utkuoguzman/Microduck/docs/media/microduck_gifs/real-robot.gif

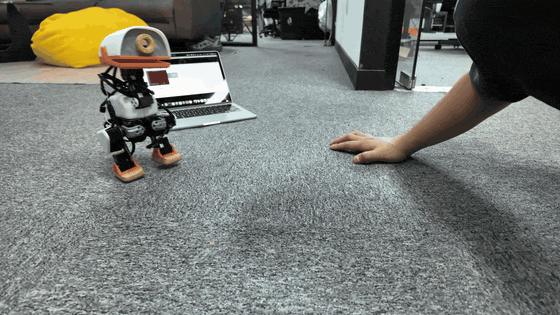
docs/media/microduck_gifs/real-robot.gif
