utkuoguzman/Microduck/docs/media/pcba-v1.1/ArduinoUnoQ-board-photo.jpg

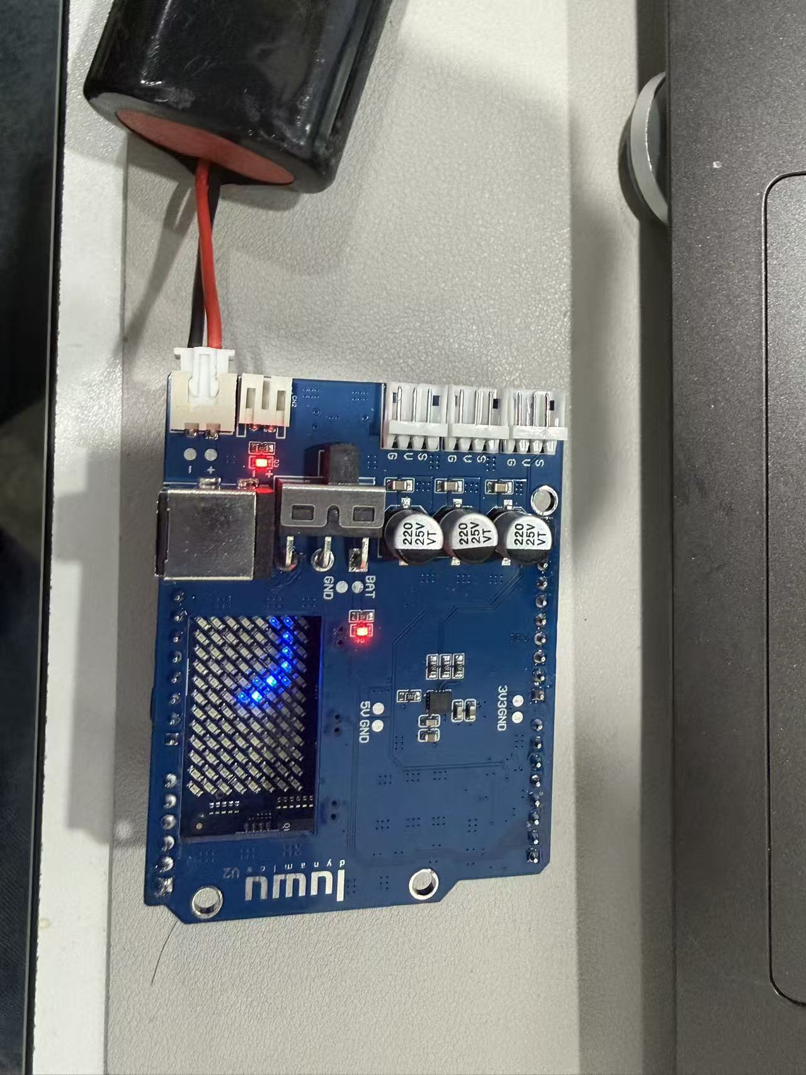
docs/media/pcba-v1.1/ArduinoUnoQ-board-photo.jpg
