utkuoguzman/Microduck/docs/media/xgo-duck-hero.jpg

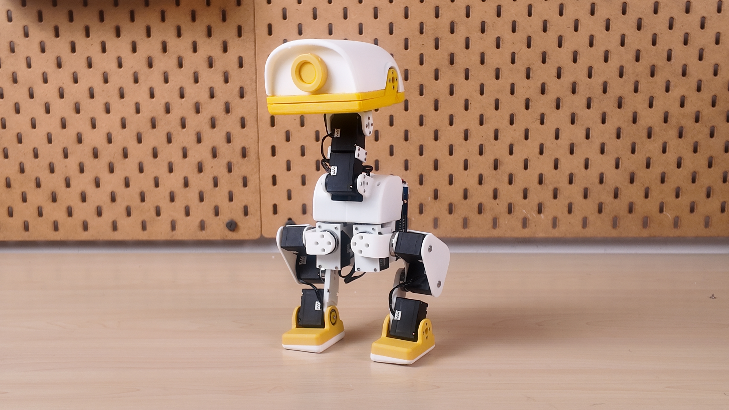
docs/media/xgo-duck-hero.jpg
