utkuoguzman/Microduck/docs/media/xgo-duck-open-beak.jpg

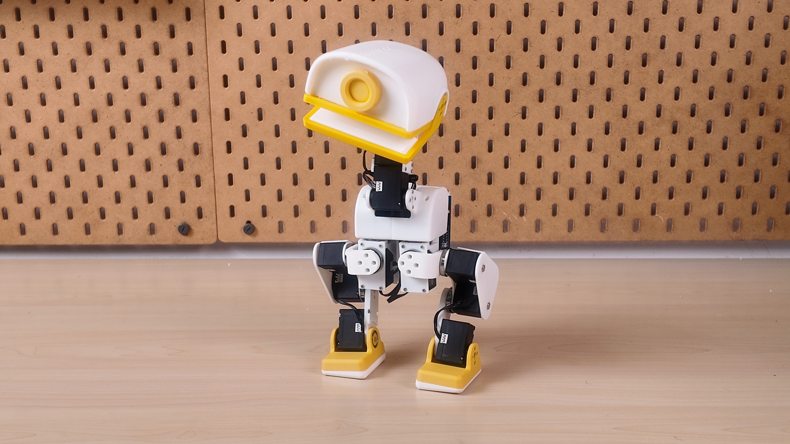
docs/media/xgo-duck-open-beak.jpg
