utkuoguzman/Microduck/docs/media/xgo-duck-rear.jpg

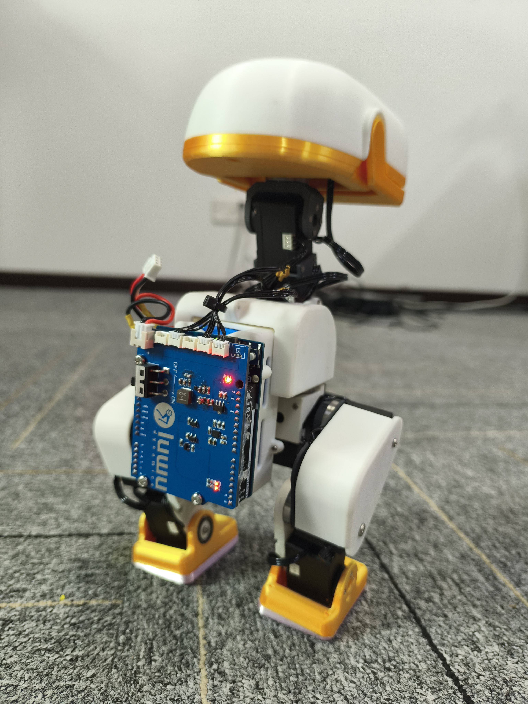
docs/media/xgo-duck-rear.jpg
