utkuoguzman/Microduck/docs/media/xgo-duck-somersault.webp

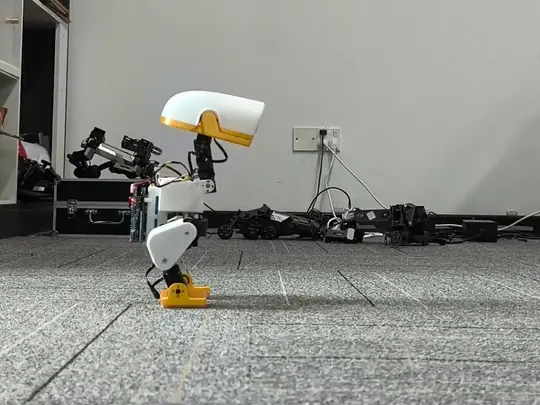
docs/media/xgo-duck-somersault.webp
