utkuoguzman/Microduck/simulation/bam_actuator/docs/_static/traj_lift_and_drop.png

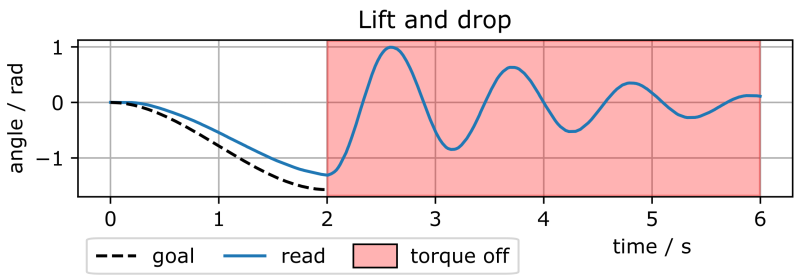
simulation/bam_actuator/docs/_static/traj_lift_and_drop.png
