utkuoguzman/Microduck/simulation/bam_actuator/docs/_static/traj_sin_sin.png

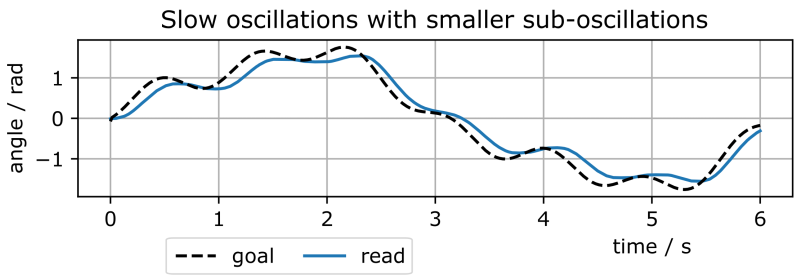
simulation/bam_actuator/docs/_static/traj_sin_sin.png
