utkuoguzman/Microduck/simulation/bam_actuator/docs/_static/traj_sin_time_square.png

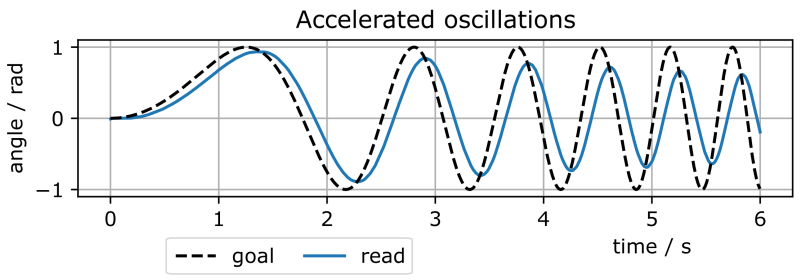
simulation/bam_actuator/docs/_static/traj_sin_time_square.png
