utkuoguzman/Microduck/simulation/bam_actuator/docs/_static/traj_up_and_down.png

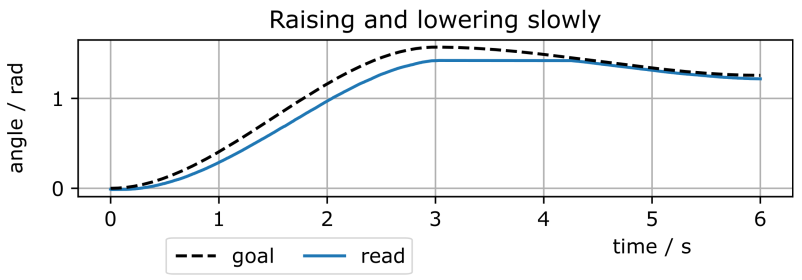
simulation/bam_actuator/docs/_static/traj_up_and_down.png
