utkuoguzman/Microduck/diagrams/reference_pcba/BOM/ArduinoUnoQV1.1.xlsx

Comment | Description | Designator | Footprint | Quantity | Value
1uf/25V | 0603贴片电容，±10%，50V | C1, C14 | C0603 | 2 | 1uf/25V
100nf/25V | 0603贴片电容，±10%，50V | C2, C5, C6, C8, C9, C11, C13, C16, C19 | C0603 | 9 | 100nf/25V
220nf/25V | 0603贴片电容，±10%，50V | C3 | C0603 | 1 | 220nf/25V
10uf/25V | 0603贴片电容，±10%，50V | C4, C7, C18 | C0603 | 3 | 10uf/25V
33pf/25V | 0603贴片电容，±10%，50V | C10 | C0603 | 1 | 33pf/25V
15uF/16V | 精度:±10%;额定电压:50V;温度系数:X7R; | C12 | C0805 | 1 | 15uF/16V
10nf/25V | 0603贴片电容，±10%，50V | C15 | C0603 | 1 | 10nf/25V
22uF | 精度:±10%;额定电压:50V;温度系数:X7R; | C17 | C0805 | 1 | 22uF
100nF | 精度:±10%;额定电压:50V;温度系数:X7R; | C20, C22, C24 | C0805 | 3 | 100nF
rvt1e221m0607 | 铝电解电容，220uF，25V，±20%，贴片 | C21, C23, C25 | CAP-SMD_BD6.3-L6.6-W6.6-LS7.4-FD | 3 | 220uF
ZX-XH2.54-2PWZ | 插针结构:1x2P;间距:2.5mm;安装方式:弯插;参考系列:XH;总PIN数:2P;排数:1;每排PIN数:2;行距:-;额定电流:2A;触头材质:黄铜;触头镀层:锡;工作温度:-25℃~+85℃; | CN1 | CONN-TH_2P-P2.50_ZX-XH2.54-2PWZ | 1
b2b-ph-sm4-tb(lf)(sn) | 插针结构:1x2P;间距:2mm;安装方式:立贴;参考系列:PH;总PIN数:2P;排数:1;每排PIN数:2;行距:-;额定电流:2A;触头材质:铜合金;触头镀层:锡;工作温度:-25℃~+85℃; | CN2 | CONN-SMD_B2B-PH-SM4-TB-LF-SN | 1
smbj9.0a-e3/5b | 极性:单向;反向截止电压(Vrwm):9V;钳位电压:15.4V;峰值脉冲电流(Ipp):39A@10/1000us;峰值脉冲功率(Ppp):600W@10/1000us;击穿电压(VBR):11.1V; | D1, D2, D5 | SMB_L4.3-W3.6-LS5.4-R-RD | 3
LED/R | Typical INFRARED GaAs LED | D3, D4 | D_SOD_523 | 2
kh-dc-007b-2.1g | 连接器类型:DC电源插座;安装方式:弯插;触点内径:-;触点外径:-;额定电流:3A;额定电压:50V;工作温度:-30℃~+70℃; | DC1 | DC-IN-TH_KH-DC-007B-2.1G | 1
smd2920p300tf/15 | 耐压(Vmax):-;最大电流(Imax):-;保持电流(Ihold):3A;跳闸电流(Itrip):-; | F1, F2, F3 | F2920 | 3
pz254v-11-06p | 插针结构:1x6P;间距:2.54mm;行距:-;圆针/方针:方针;安装方式:直插;排数:单排;总PIN位数:6P;额定电流:3A;额定电压:-;配合针长度:6mm;塑高:2.5mm;端接针长度:3mm;触头材质:黄铜;触头镀层:金;工作温度:-40℃~+105℃;颜色:黑色; | H1 | HDR-TH_6P-P2.54-V-M | 1
pz254v-11-10p | 插针结构:1x10P;间距:2.54mm;行距:-;圆针/方针:方针;安装方式:直插;排数:单排;总PIN位数:10P;额定电流:3A;额定电压:250V;配合针长度:6mm;塑高:2.5mm;端接针长度:3mm;触头材质:黄铜;触头镀层:-;工作温度:-40℃~+105℃;颜色:黑色; | H2 | HDR-TH_10P-P2.54-V-M | 1
pz254v-11-08p | 插针结构:1x8P;间距:2.54mm;行距:-;圆针/方针:方针;安装方式:直插;排数:单排;总PIN位数:8P;额定电流:3A;额定电压:250V;配合针长度:6mm;塑高:2.5mm;端接针长度:3mm;触头材质:黄铜;触头镀层:-;工作温度:-40℃~+105℃;颜色:黑色; | H3, H4 | HDR-TH_8P-P2.54-V-M | 2
pio75-2r7mt | 电感值:2.7uH;精度:±20%;额定电流:5A;饱和电流(Isat):-;类型:非屏蔽电感; | L1 | IND-SMD_L7.8-W7.0-A | 1 | 2.7uH
292253-3 | 插针结构:1x3P;间距:2mm;安装方式:弯插;总PIN数:3P;排数:1;每排PIN数:3;额定电流:4A;触头材质:黄铜;触头镀层:锡;工作温度:-40℃~+105℃; | P1, P2, P3 | CONN-TH_3P-P2.00_TE_292253-3 | 3
aosp36326c | 这款N沟道场效应管专为低压大电流应用优化，在30V的耐压架构下实现了10A的持续电流吞吐能力。其核心优势在于9mΩ的极低导通电阻，这一特性显著降低了导通损耗，使得器件在紧凑的PCB布局中也能保持良好的热表现。20V的栅源电压范围确保了驱动电路设计的灵活性与稳健性。该器件非常适合应用于便携式设备的电源管理、锂电池保护电路以及各类DC/DC同步整流模块，能够高效处理负载切换与功率分配任务。 | Q1 | SOIC-8_L4.9-W3.9-P1.27-LS6.0-BL | 1
BC807 | hfe=250~600 PNP 电流:500mA 电压:45V | Q2 | SOT-23-3 | 1
AMS1117-3.3V | 输入18V 输出3.3V 1A，SOT-89封装 | Q3 | SOT-89-3_L4.5-W2.5-P1.50-LS4.2-BR | 1
10K/±1% | 厚膜电阻 ±1% 100mW, 厚膜电阻 ±1% 100mW | R1, R6, R7, R11, R12, R13 | R0603 | 6
4.7K/±1% | 厚膜电阻 ±1% 100mW | R2, R3, R4 | R0603 | 3
10Ω/±1% | 厚膜电阻 ±1% 100mW | R5 | R0603 | 1
220K/±1% | 电阻类型:厚膜电阻;阻值:10kΩ;精度:±1%;功率:100mW;工作电压:75V;温度系数:±100ppm/℃; | R8 | R0603 | 1
30K/±1% | 电阻类型:厚膜电阻;阻值:10kΩ;精度:±1%;功率:100mW;工作电压:75V;温度系数:±100ppm/℃; | R9 | R0603 | 1
20K/±1% | 厚膜电阻 ±1% 100mW | R10, R14 | R0603 | 2
SN74LVC1G126 | 三态输出，单路总线缓冲门 | SN1 | SOT_23_5 | 1
SN74LVC1G125 | 单总线缓冲门，带三态输出 | SN2 | SOT_23_5 | 1
SS-12D06L5 | 电路结构:单刀双掷;安装方式:-;开关颜色:黑色;额定电流:3A;额定电压:125V;工作寿命:1万次; | SW1 | SW-TH_3P-P4.70_L11.1-W12.7 | 1
TestPoint | 测试点 | T1, T2, T5, T6, T7, T8, T9, T10 | TsetPoint | 8
QMI8658A | 六轴陀螺仪 陀螺仪量程(MAX) ±2048dps 加速度计量程(MAX) ±16g | U1 | LGA-14_L3.0-W2.5-P0.50-TL | 1
lm74502ddfr | 类型:高侧开关;输入控制逻辑:高电平有效;工作电压:3.2V~65V;导通电阻:2Ω; | U2 | SOT-23-8_L2.9-W1.6-P0.65-LS2.8-BL | 1
TPS566238RQFR | 功能类型:降压型;工作电压:3V~18V;输出电压:600mV~7V;输出电流:6A;输出类型:可调; | U3 | QFN-9_L2.0-W1.5-P0.50-TL_TPS566238PRQFR | 1
