utkuoguzman/Microduck/docs/media/bom/battery-reference.png

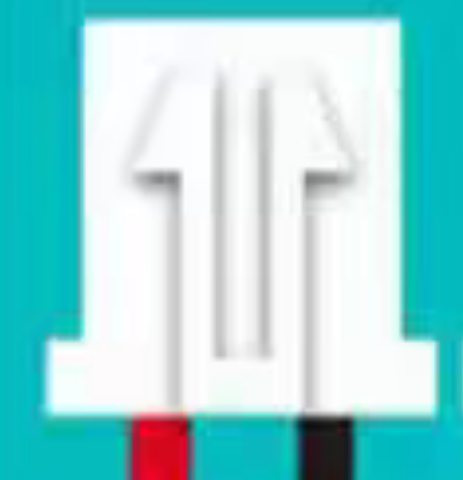
docs/media/bom/battery-reference.png
