utkuoguzman/Microduck/docs/media/bom/round-head-reference.jpg

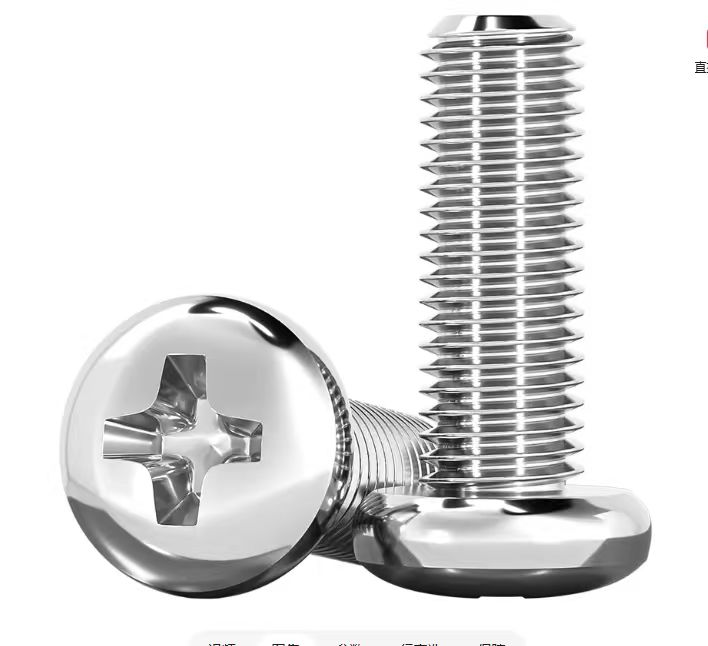
docs/media/bom/round-head-reference.jpg
