utkuoguzman/Microduck/3d_models/microduck_print_plate.3mf

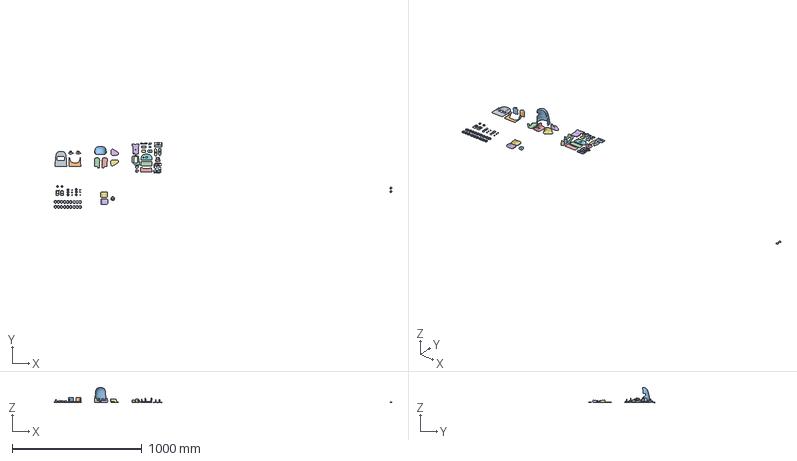
[picture p16: CAD file, 2026-11-03]
3d_models/microduck_print_plate.3mf
2603.7 x 508.5 x 116.1 mm
3.obj
4.obj
5.obj
7.obj
8.obj
a.obj
b.obj x 2
d.obj
e.obj
f.obj
g.obj
h.obj
i.obj
j.obj
k.obj
l.obj
m.obj
n.obj
o.obj
p.obj
q.obj
111.obj
222.obj
333.obj
dfvdfb.obj x 2
ersgtbgertgestrg.obj x 18
idle_horn.stl x 8
idle_cap.stl x 6
rgbn.obj x 2
grbrgn.obj
thngthm.obj
dfbdfbbbbb1.obj
fgb.obj
gbgb.obj
ghmghmghmghm.obj
