utkuoguzman/Microduck/3d_models/xgoduck_v2_numbered_stls/obj_1_大腿右外壳.stl

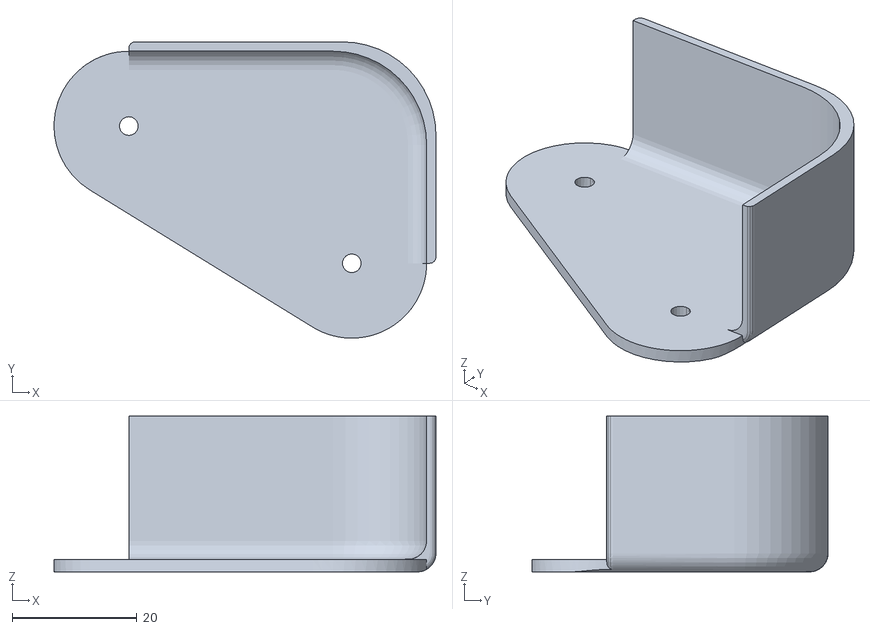
[picture p17: CAD file, 2026-11-03]
3d_models/xgoduck_v2_numbered_stls/obj_1_大腿右外壳.stl
61.2 x 47.5 x 25.0
