utkuoguzman/Microduck/3d_models/xgoduck_v2_structure_stls/2x_thigh_support.stl

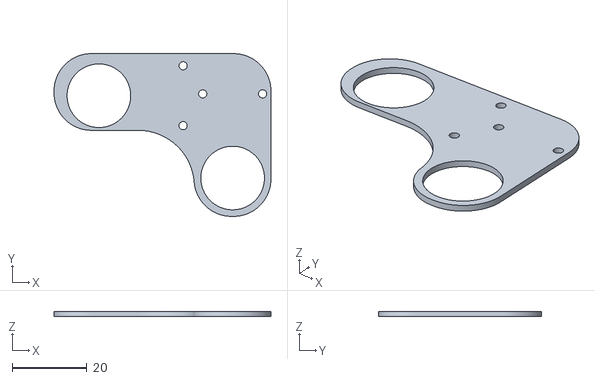
[picture p18: CAD file, 2026-11-03]
3d_models/xgoduck_v2_structure_stls/2x_thigh_support.stl
58.0 x 43.5 x 1.40
