utkuoguzman/Microduck/diagrams/reference_pcba/Step/ArduinoUnoQV1.1.step

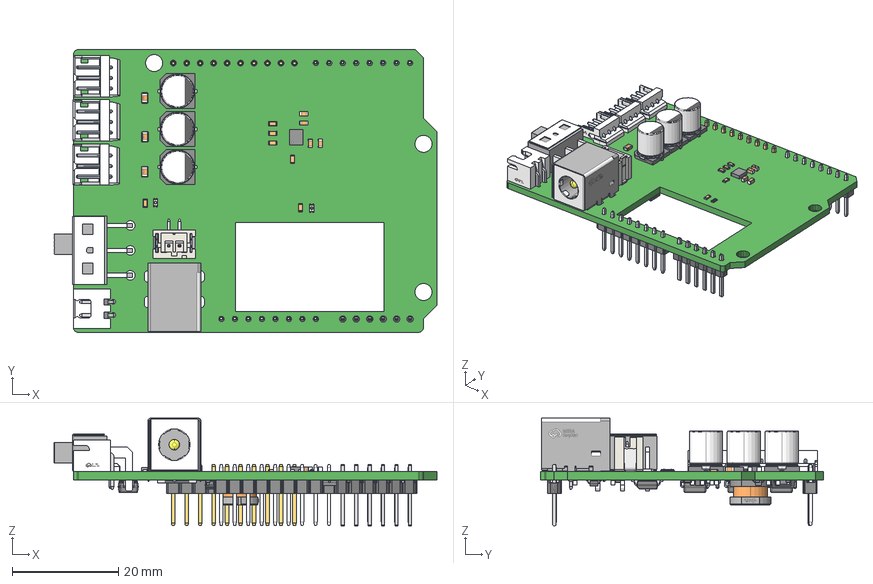
[picture p19: CAD file, 2026-11-03]
diagrams/reference_pcba/Step/ArduinoUnoQV1.1.step
72.2 x 53.3 x 20.3 mm
CONN-SMD_B2B-PH-SM4-TB-LF-SN~CONN-SMD_B2B-PH-SM4-TB-LF-SN~hrXI
CONN-SMD_B2B-PH-SM4-TB-LF-SN~CONN-SMD_B2B-PH-SM4-TB-LF-SN~hrXI001
CONN-SMD_B2B-PH-SM4-TB-LF-SN~CONN-SMD_B2B-PH-SM4-TB-LF-SN~hrXI002
0805 SMD Capacitor x 5
IND-SMD_L7.8-W7.0-A~IND-SMD_L7.8-W7.0-A~hbJM
User Library-LGA-14L
User Library-SOT23-5_SOT23-5 Connector_Default x 10
User Library-SOT23-5_SOT23-5 Body_Default x 2
C0603_040 x 42
CircuitWorks-SOT-89
SOT-23-3_L2.9-W1.4-P1.91-LS2.6-BR~SOT-23-3_ L2.9-W1.4-P1.91-LS2.6-BR~RG96
SOT-23-3_L2.9-W1.4-P1.91-LS2.6-BR~SOT-23-3_ L2.9-W1.4-P1.91-LS2.6-BR~RG001
SOT-23-3_L2.9-W1.4-P1.91-LS2.6-BR~SOT-23-3_ L2.9-W1.4-P1.91-LS2.6-BR~RG002
SOT-23-3_L2.9-W1.4-P1.91-LS2.6-BR~SOT-23-3_ L2.9-W1.4-P1.91-LS2.6-BR~RG003
SOT-23-3_L2.9-W1.4-P1.91-LS2.6-BR~SOT-23-3_ L2.9-W1.4-P1.91-LS2.6-BR~RG004
SOT-23-3_L2.9-W1.4-P1.91-LS2.6-BR~SOT-23-3_ L2.9-W1.4-P1.91-LS2.6-BR~RG005
SOT-23-3_L2.9-W1.4-P1.91-LS2.6-BR~SOT-23-3_ L2.9-W1.4-P1.91-LS2.6-BR~RG006
SOT-23-3_L2.9-W1.4-P1.91-LS2.6-BR~SOT-23-3_ L2.9-W1.4-P1.91-LS2.6-BR~RG007
SOT-23-3_L2.9-W1.4-P1.91-LS2.6-BR~SOT-23-3_ L2.9-W1.4-P1.91-LS2.6-BR~RG008
SOT-23-3_L2.9-W1.4-P1.91-LS2.6-BR~SOT-23-3_ L2.9-W1.4-P1.91-LS2.6-BR~RG009
SOT-23-3_L2.9-W1.4-P1.91-LS2.6-BR~SOT-23-3_ L2.9-W1.4-P1.91-LS2.6-BR~RG010
SOT-23-3_L2.9-W1.4-P1.91-LS2.6-BR~SOT-23-3_ L2.9-W1.4-P1.91-LS2.6-BR~RG011
SOT-23-3_L2.9-W1.4-P1.91-LS2.6-BR~SOT-23-3_ L2.9-W1.4-P1.91-LS2.6-BR~RG012
SOT-23-3_L2.9-W1.4-P1.91-LS2.6-BR~SOT-23-3_ L2.9-W1.4-P1.91-LS2.6-BR~RG013
LOGOԲ x 2
LED 0603-W x 2
0603_C x 17
QFN-9_L2.0-W1.5-P0.50-TL_TPS566238PRQFR~QFN-9_L2.0-W1.5-P0.50-TL_ TPS566238PRQFR~mSyB
SOT-23-8_L2.9-W1.6-P0.65-LS2.8-BL~TSOT-23-8_ L2.9-W1.6-H1.1-LS2.8-P0.65~SrHR
SOT-23-8_L2.9-W1.6-P0.65-LS2.8-BL~TSOT-23-8_ L2.9-W1.6-H1.1-LS2.8-P0.65~SrHR001
SOT-23-8_L2.9-W1.6-P0.65-LS2.8-BL~TSOT-23-8_ L2.9-W1.6-H1.1-LS2.8-P0.65~SrHR002
SOT-23-8_L2.9-W1.6-P0.65-LS2.8-BL~TSOT-23-8_ L2.9-W1.6-H1.1-LS2.8-P0.65~SrHR003
SOT-23-8_L2.9-W1.6-P0.65-LS2.8-BL~TSOT-23-8_ L2.9-W1.6-H1.1-LS2.8-P0.65~SrHR004
SOT-23-8_L2.9-W1.6-P0.65-LS2.8-BL~TSOT-23-8_ L2.9-W1.6-H1.1-LS2.8-P0.65~SrHR005
SOT-23-8_L2.9-W1.6-P0.65-LS2.8-BL~TSOT-23-8_ L2.9-W1.6-H1.1-LS2.8-P0.65~SrHR006
SOT-23-8_L2.9-W1.6-P0.65-LS2.8-BL~TSOT-23-8_ L2.9-W1.6-H1.1-LS2.8-P0.65~SrHR007
SOT-23-8_L2.9-W1.6-P0.65-LS2.8-BL~TSOT-23-8_ L2.9-W1.6-H1.1-LS2.8-P0.65~SrHR008
SW-TH_3P-P4.70_L11.1-W12.7~SW-TH_3P-P4.70_L11.1-W12.7~vEMC
SW-TH_3P-P4.70_L11.1-W12.7~SW-TH_3P-P4.70_L11.1-W12.7~vEMC001
SW-TH_3P-P4.70_L11.1-W12.7~SW-TH_3P-P4.70_L11.1-W12.7~vEMC002
SW-TH_3P-P4.70_L11.1-W12.7~SW-TH_3P-P4.70_L11.1-W12.7~vEMC003
SW-TH_3P-P4.70_L11.1-W12.7~SW-TH_3P-P4.70_L11.1-W12.7~vEMC004
SW-TH_3P-P4.70_L11.1-W12.7~SW-TH_3P-P4.70_L11.1-W12.7~vEMC005
SW-TH_3P-P4.70_L11.1-W12.7~SW-TH_3P-P4.70_L11.1-W12.7~vEMC006
SW-TH_3P-P4.70_L11.1-W12.7~SW-TH_3P-P4.70_L11.1-W12.7~vEMC007
SW-TH_3P-P4.70_L11.1-W12.7~SW-TH_3P-P4.70_L11.1-W12.7~vEMC008
SW-TH_3P-P4.70_L11.1-W12.7~SW-TH_3P-P4.70_L11.1-W12.7~vEMC009
SW-TH_3P-P4.70_L11.1-W12.7~SW-TH_3P-P4.70_L11.1-W12.7~vEMC010
SW-TH_3P-P4.70_L11.1-W12.7~SW-TH_3P-P4.70_L11.1-W12.7~vEMC011
SW-TH_3P-P4.70_L11.1-W12.7~SW-TH_3P-P4.70_L11.1-W12.7~vEMC012
SW-TH_3P-P4.70_L11.1-W12.7~SW-TH_3P-P4.70_L11.1-W12.7~vEMC013
SOIC-8_L4.9-W3.9-P1.27-LS6.0-BL~SOIC-8_L4.9-W3.9-H1.7-LS6.0-P1.27~Urlb
CONN-TH_3P-P2.00_TE_292253-3~CONN-TH_3P-P2.00_TE_292253-3~qq6q x 3
CONN-TH_3P-P2.00_TE_292253-3~CONN-TH_3P-P2.00_TE_292253-3~qq6q001 x 3
CONN-TH_3P-P2.00_TE_292253-3~CONN-TH_3P-P2.00_TE_292253-3~qq6q002 x 3
CONN-TH_3P-P2.00_TE_292253-3~CONN-TH_3P-P2.00_TE_292253-3~qq6q003 x 3
CONN-TH_3P-P2.00_TE_292253-3~CONN-TH_3P-P2.00_TE_292253-3~qq6q004 x 3
CONN-TH_3P-P2.00_TE_292253-3~CONN-TH_3P-P2.00_TE_292253-3~qq6q005 x 3
CONN-TH_3P-P2.00_TE_292253-3~CONN-TH_3P-P2.00_TE_292253-3~qq6q006 x 3
CONN-TH_3P-P2.00_TE_292253-3~CONN-TH_3P-P2.00_TE_292253-3~qq6q007 x 3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
