utkuoguzman/Microduck/simulation/microduck_mjcf/mjcf/assets/tibia__configuration_left.stl

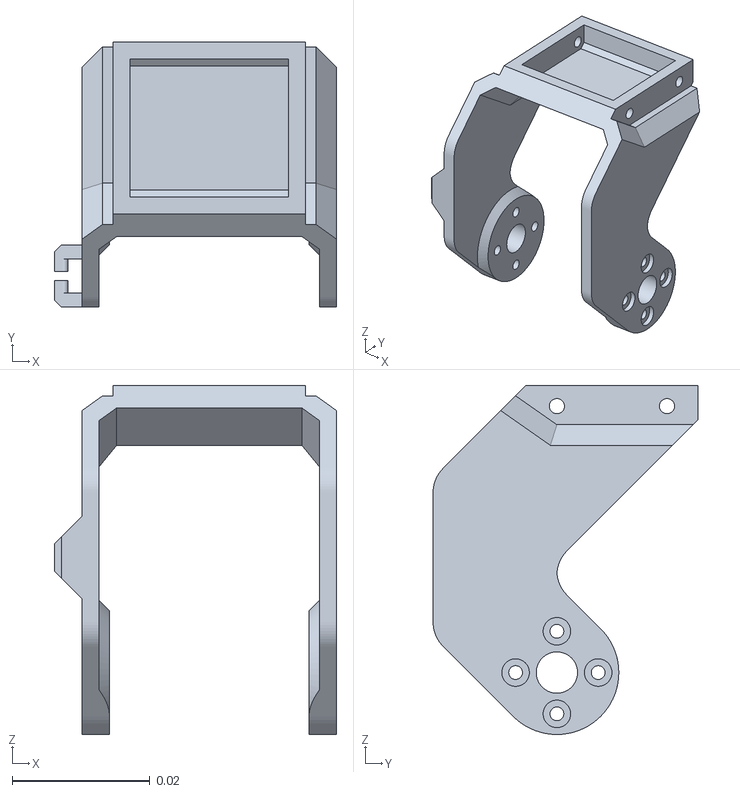
[picture p20: CAD file, 2026-11-03]
simulation/microduck_mjcf/mjcf/assets/tibia__configuration_left.stl
0.041 x 0.0385 x 0.0507
