utkuoguzman/Microduck/simulation/xgoduck_mjcf/assets/right_hip_yaw.stl

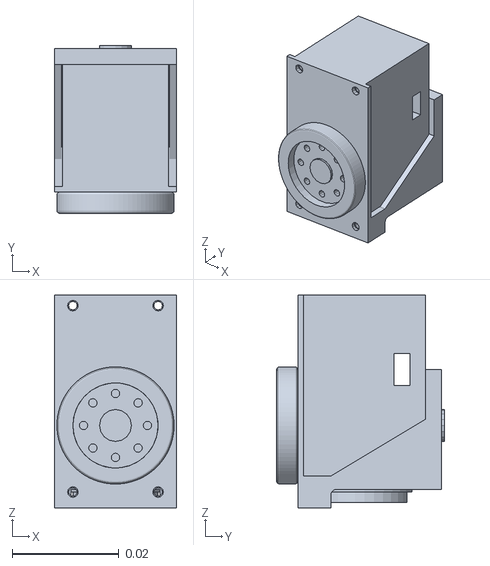
[picture p21: CAD file, 2026-11-03]
simulation/xgoduck_mjcf/assets/right_hip_yaw.stl
0.023 x 0.0315 x 0.04
