utkuoguzman/Microduck/3d_models/xgoduck_v2_numbered_stls/obj_18_左脚.stl

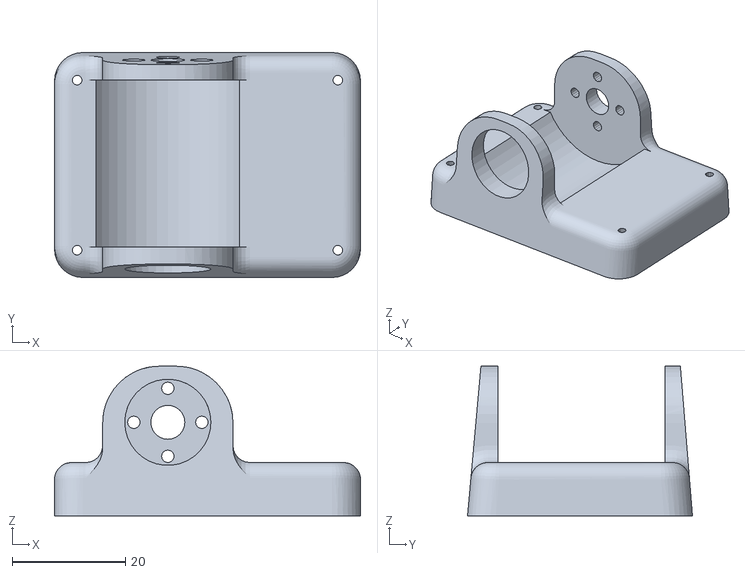
[picture p22: CAD file, 2026-11-03]
3d_models/xgoduck_v2_numbered_stls/obj_18_左脚.stl
54.0 x 39.7 x 26.4
