utkuoguzman/Microduck/3d_models/xgoduck_v2_structure_stls/2x_ankle_axis.STL

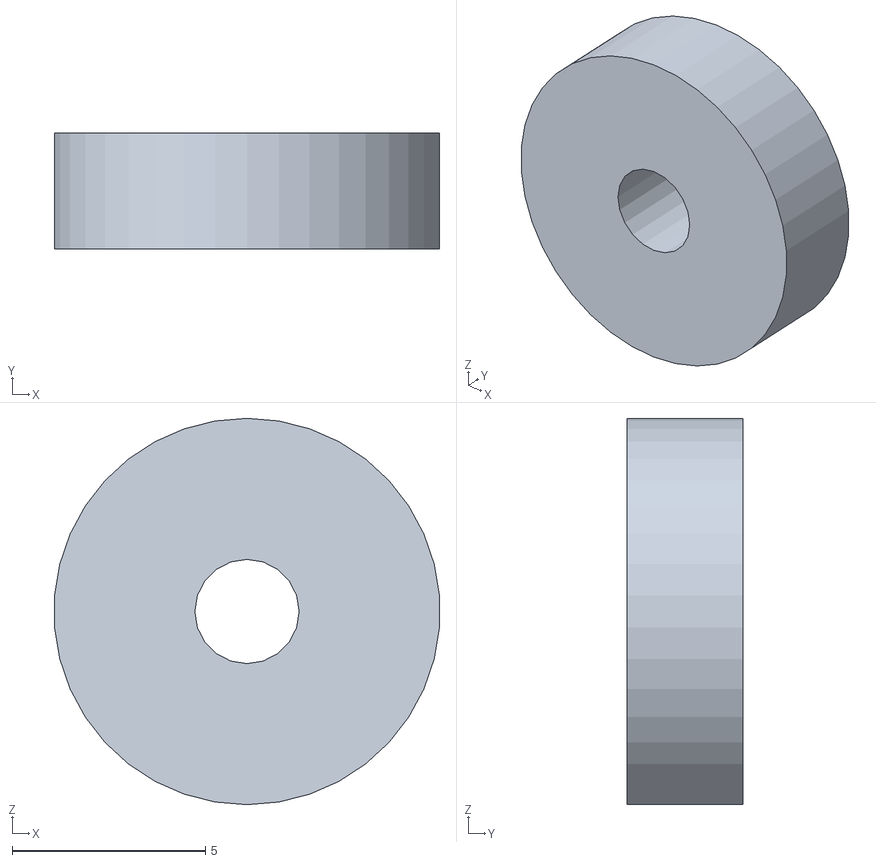
[picture p23: CAD file, 2026-11-03]
3d_models/xgoduck_v2_structure_stls/2x_ankle_axis.STL
9.97 x 3.00 x 10.0
