utkuoguzman/Microduck/simulation/microduck_mjcf/mjcf/assets/trunk_top__configuration_right.stl

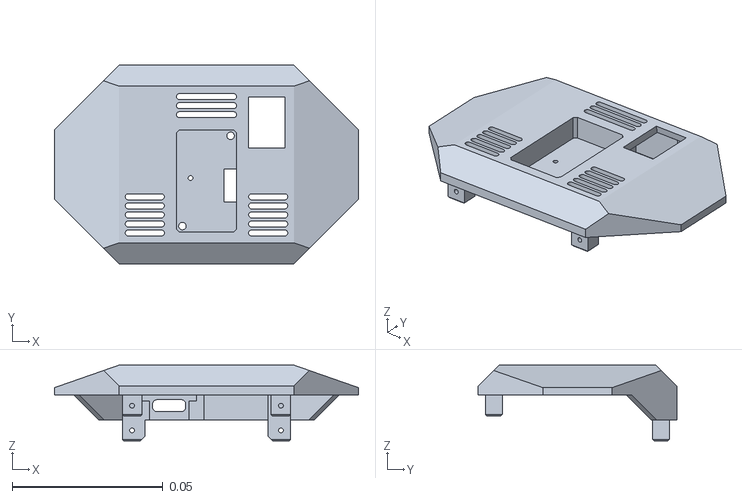
[picture p24: CAD file, 2026-11-03]
simulation/microduck_mjcf/mjcf/assets/trunk_top__configuration_right.stl
0.101 x 0.066 x 0.0252
