utkuoguzman/Microduck/3d_models/xgoduck_v2_structure_stls/mouth_buttom_tpu.stl

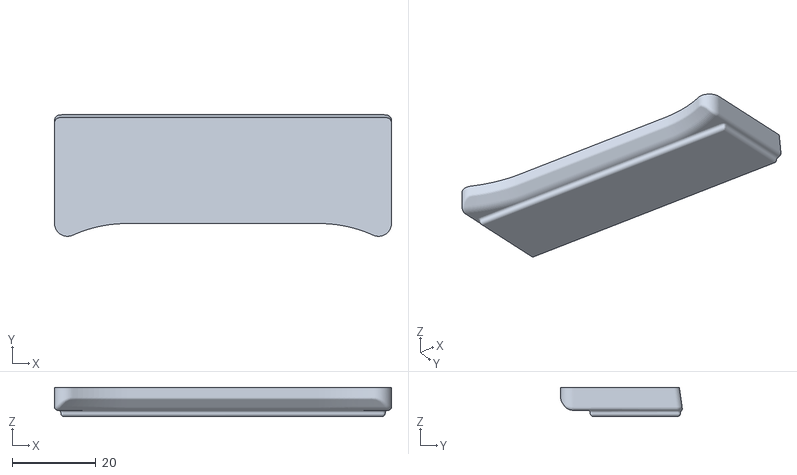
[picture p25: CAD file, 2026-11-03]
3d_models/xgoduck_v2_structure_stls/mouth_buttom_tpu.stl
80.6 x 29.1 x 7.00
