utkuoguzman/Microduck/simulation/microduck_mjcf/mjcf/assets/radius.stl

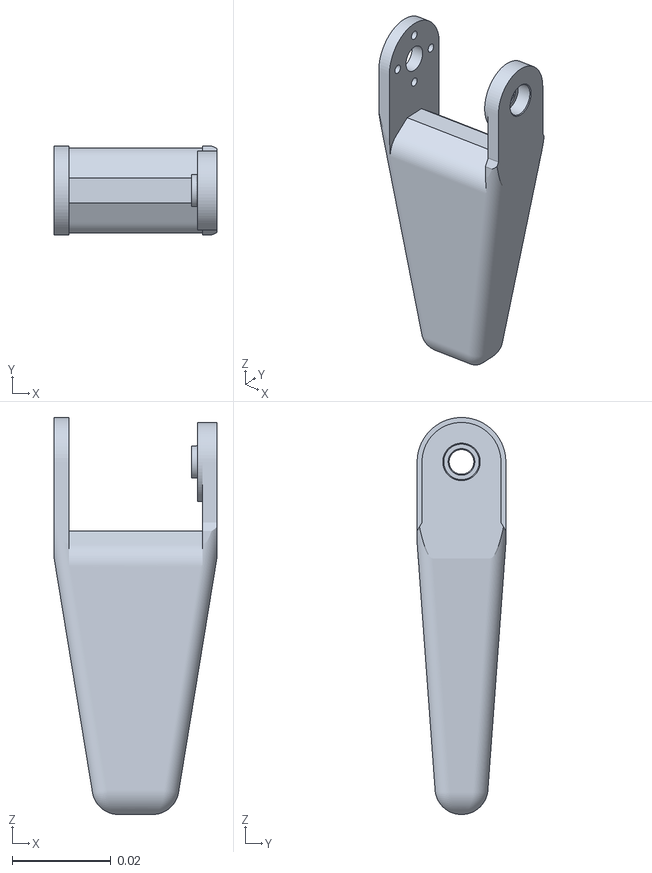
[picture p26: CAD file, 2026-11-03]
simulation/microduck_mjcf/mjcf/assets/radius.stl
0.033 x 0.018 x 0.0805
