utkuoguzman/Microduck/simulation/xgoduck_mjcf/assets/right_hip_roll.stl

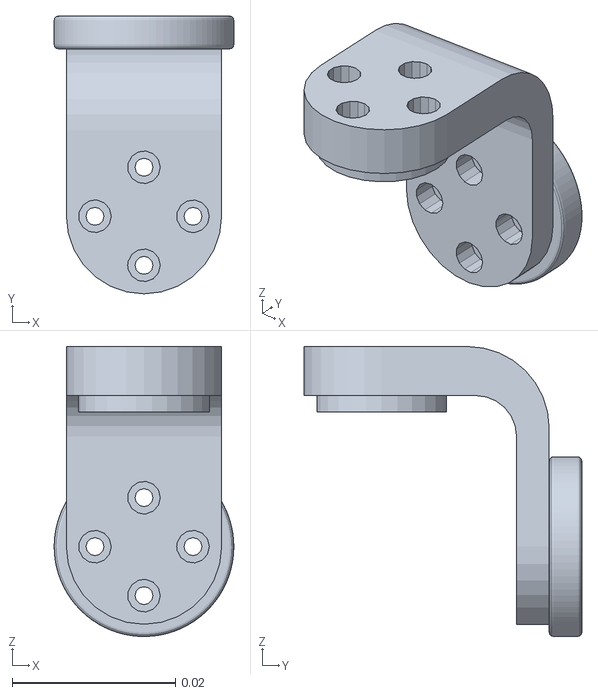
[picture p27: CAD file, 2026-11-03]
simulation/xgoduck_mjcf/assets/right_hip_roll.stl
0.022 x 0.034 x 0.0355
