utkuoguzman/Microduck/3d_models/xgoduck_v2_numbered_stls/obj_16_头部平台.stl

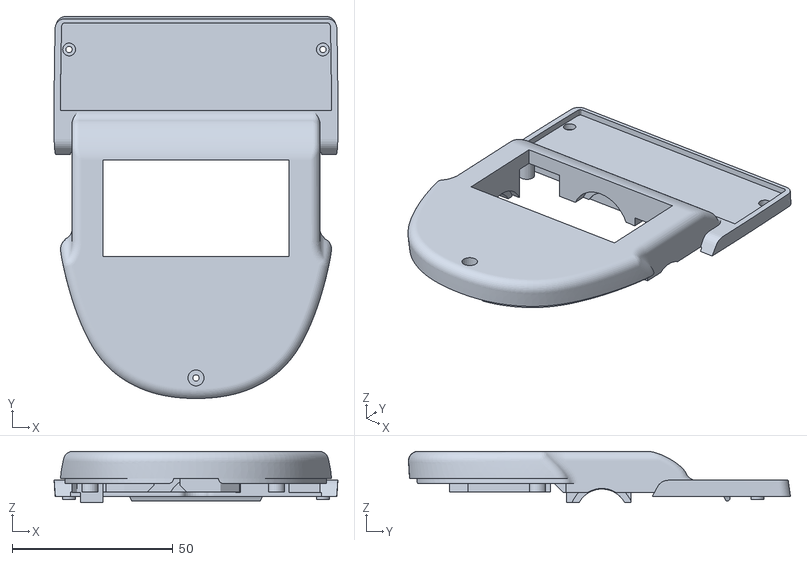
[picture p28: CAD file, 2026-11-03]
3d_models/xgoduck_v2_numbered_stls/obj_16_头部平台.stl
88.3 x 118.9 x 16.0
