utkuoguzman/Microduck/3d_models/xgoduck_v2_structure_stls/body_right_shell.stl

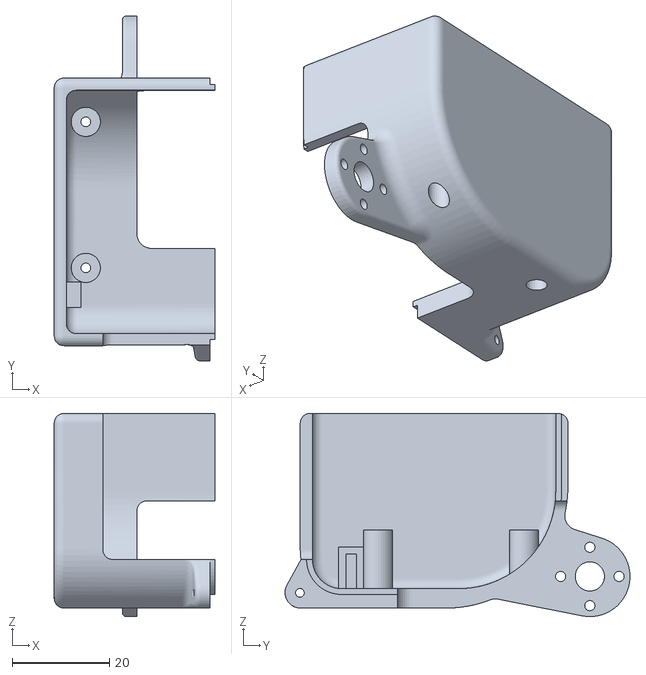
[picture p29: CAD file, 2026-11-03]
3d_models/xgoduck_v2_structure_stls/body_right_shell.stl
33.0 x 70.9 x 41.7
