utkuoguzman/Microduck/simulation/microduck_mjcf/mjcf/assets/xl330_without_horn.stl

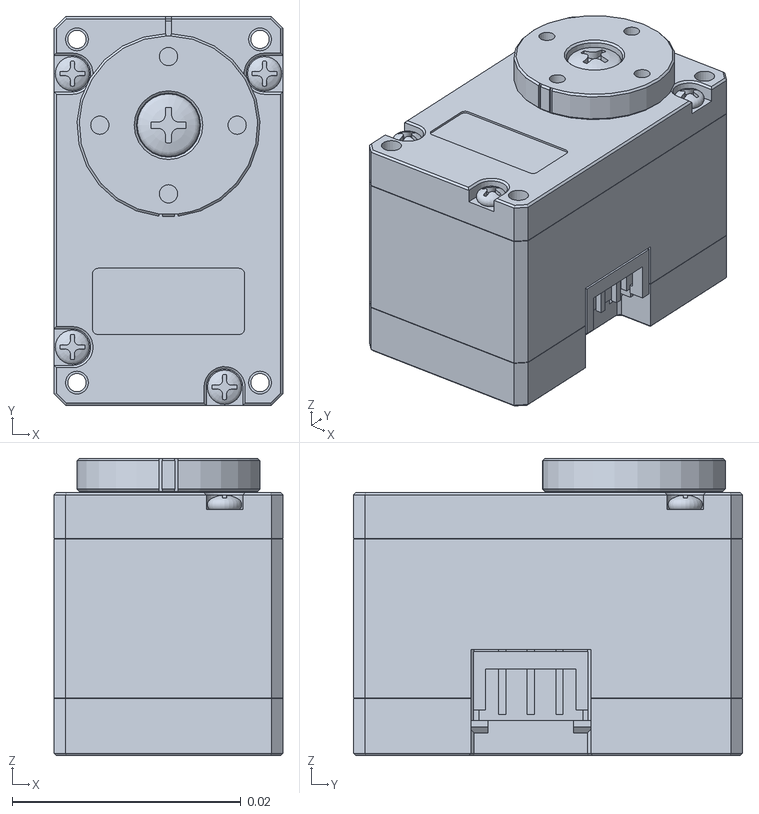
[picture p30: CAD file, 2026-11-03]
simulation/microduck_mjcf/mjcf/assets/xl330_without_horn.stl
0.02 x 0.034 x 0.026
