utkuoguzman/Microduck/simulation/xgoduck_mjcf/assets/right_hip_pitch.stl

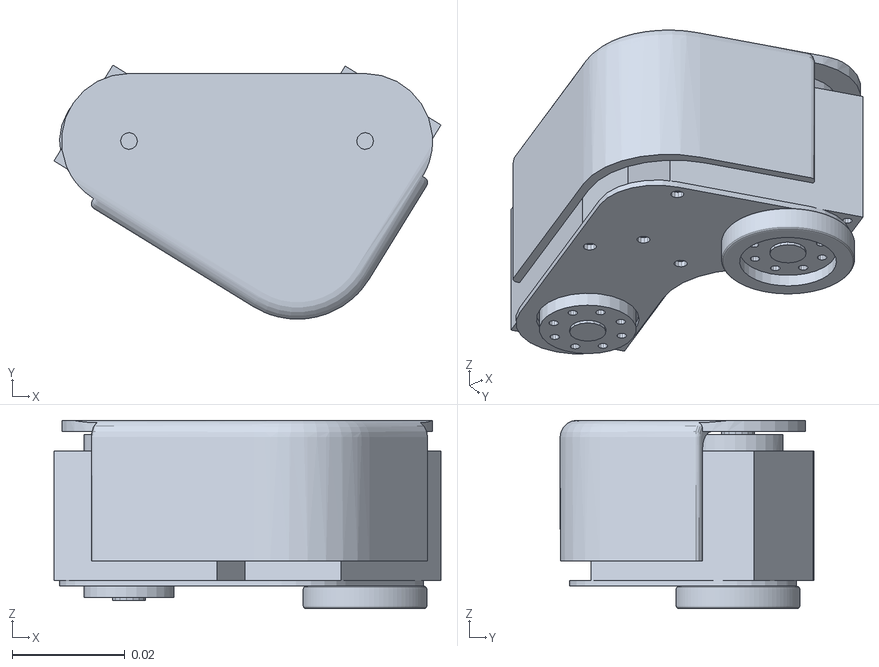
[picture p31: CAD file, 2026-11-03]
simulation/xgoduck_mjcf/assets/right_hip_pitch.stl
0.0688 x 0.0451 x 0.0335
