utkuoguzman/Microduck/3d_models/xgoduck_v2_numbered_stls/obj_9_组合体.stl

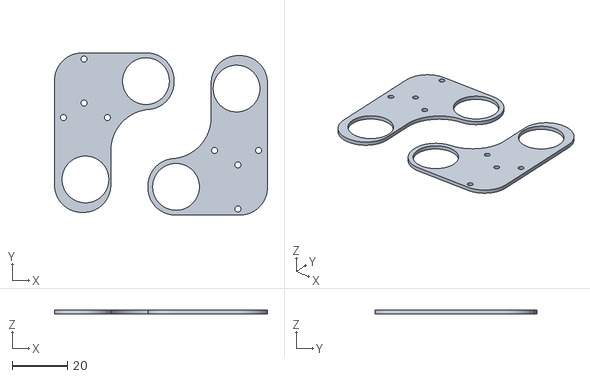
[picture p32: CAD file, 2026-11-03]
3d_models/xgoduck_v2_numbered_stls/obj_9_组合体.stl
77.4 x 59.0 x 1.40
