utkuoguzman/Microduck/3d_models/xgoduck_v2_structure_stls/4x_tire.STL

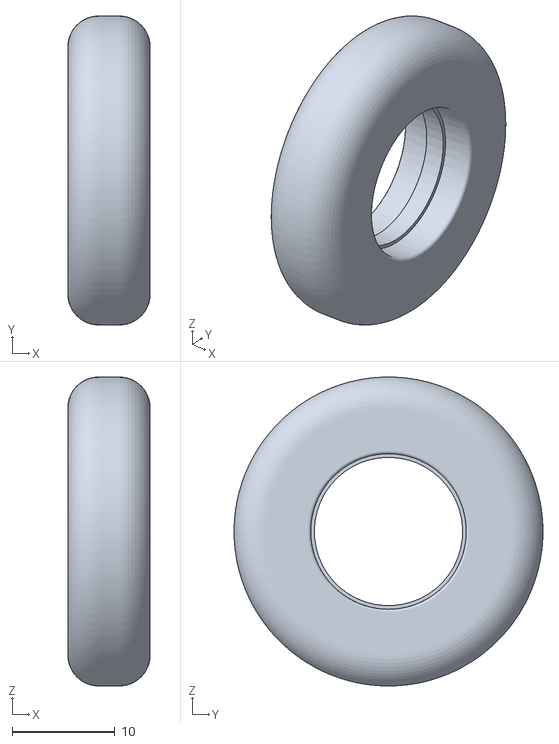
[picture p33: CAD file, 2026-11-03]
3d_models/xgoduck_v2_structure_stls/4x_tire.STL
8.00 x 30.0 x 30.0
