utkuoguzman/Microduck/simulation/microduck_mjcf/mjcf/assets/ankle_dbl_block__configuration_right.stl

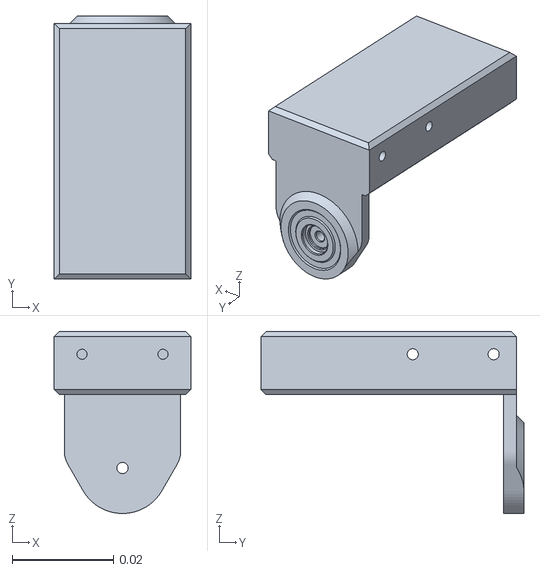
[picture p34: CAD file, 2026-11-03]
simulation/microduck_mjcf/mjcf/assets/ankle_dbl_block__configuration_right.stl
0.027 x 0.052 x 0.036
