utkuoguzman/Microduck/simulation/xgoduck_mjcf/assets/head_yaw.stl

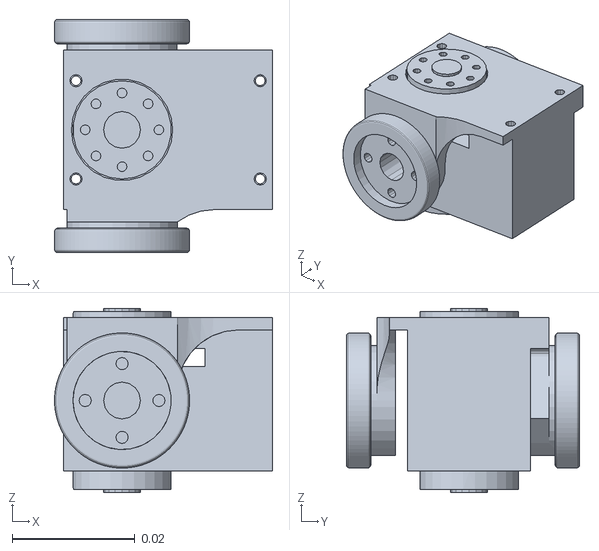
[picture p35: CAD file, 2026-11-03]
simulation/xgoduck_mjcf/assets/head_yaw.stl
0.0355 x 0.038 x 0.03
