utkuoguzman/Microduck/3d_models/xgoduck_v2_numbered_stls/obj_4_头部pitch.stl

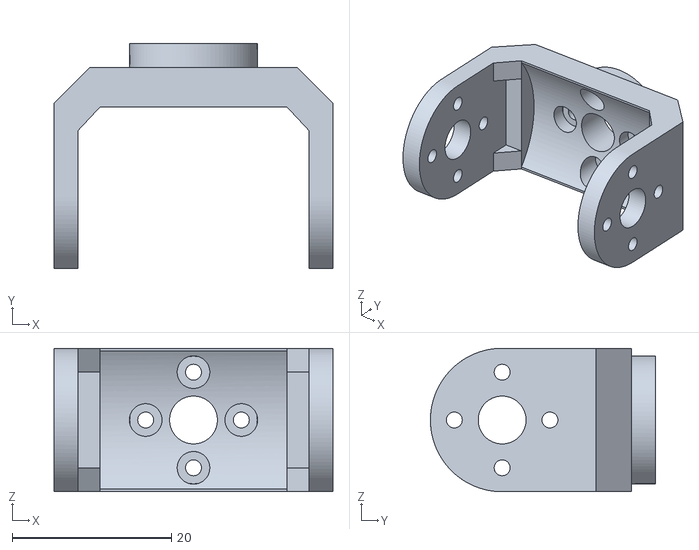
[picture p36: CAD file, 2026-11-03]
3d_models/xgoduck_v2_numbered_stls/obj_4_头部pitch.stl
35.0 x 28.2 x 18.0
