utkuoguzman/Microduck/simulation/microduck_mjcf/mjcf/assets/switch.stl

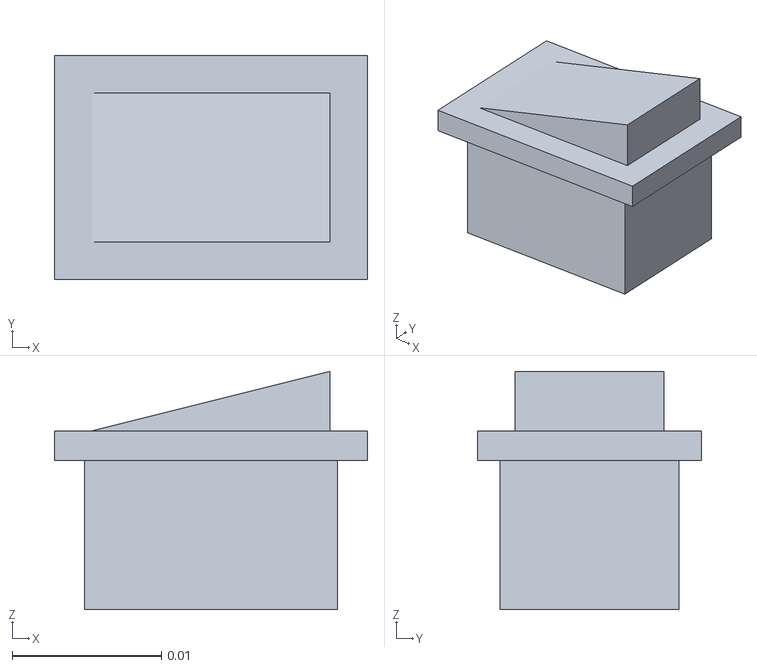
[picture p37: CAD file, 2026-11-03]
simulation/microduck_mjcf/mjcf/assets/switch.stl
0.021 x 0.015 x 0.016
