utkuoguzman/Microduck/simulation/xgoduck_mjcf/assets/head_roll.stl

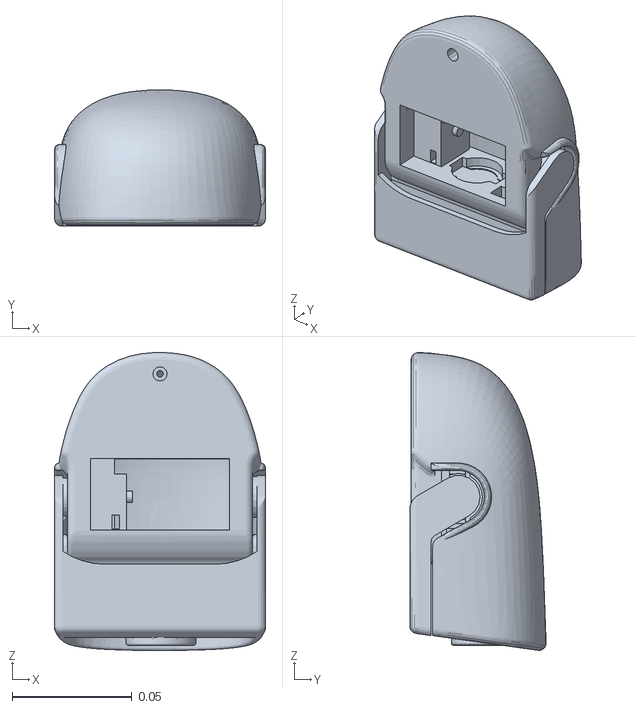
[picture p38: CAD file, 2026-11-03]
simulation/xgoduck_mjcf/assets/head_roll.stl
0.0883 x 0.0569 x 0.124
