utkuoguzman/Microduck/3d_models/xgoduck_v2_numbered_stls/obj_5_头部舵机固定件.stl

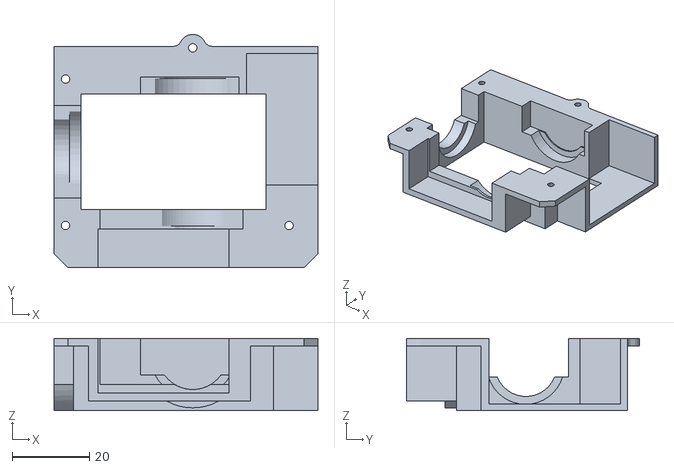
[picture p39: CAD file, 2026-11-03]
3d_models/xgoduck_v2_numbered_stls/obj_5_头部舵机固定件.stl
68.5 x 60.5 x 18.8
