utkuoguzman/Microduck/3d_models/xgoduck_v2_structure_stls/jaw.stl

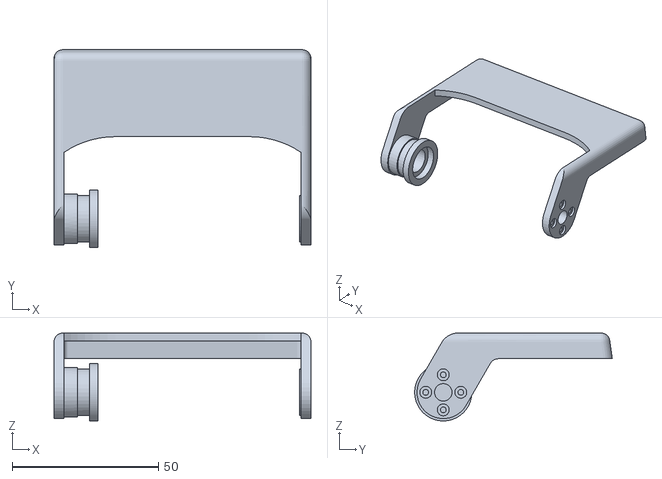
[picture p40: CAD file, 2026-11-03]
3d_models/xgoduck_v2_structure_stls/jaw.stl
88.0 x 67.7 x 30.1
