utkuoguzman/Microduck/simulation/microduck_mjcf/mjcf/assets/humerus.stl

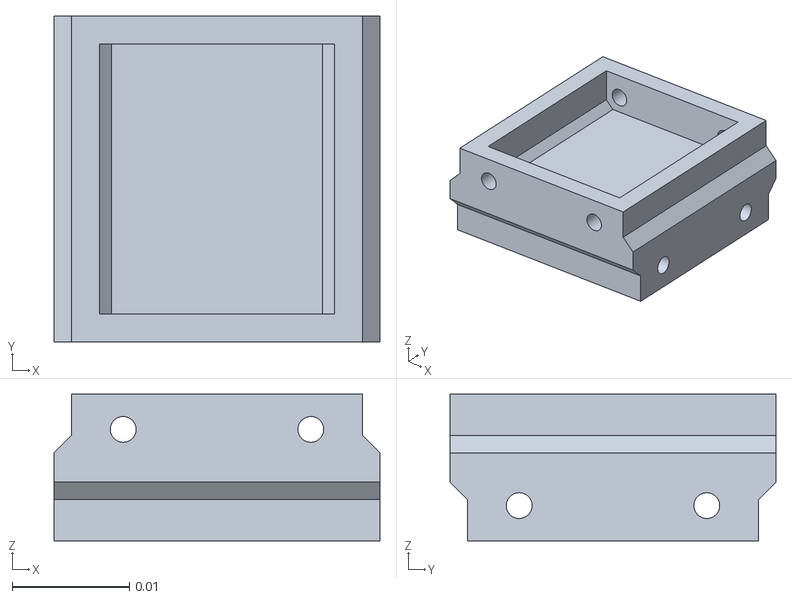
[picture p41: CAD file, 2026-11-03]
simulation/microduck_mjcf/mjcf/assets/humerus.stl
0.0278 x 0.0278 x 0.0125
