utkuoguzman/Microduck/simulation/xgoduck_mjcf/assets/trunk_base.stl

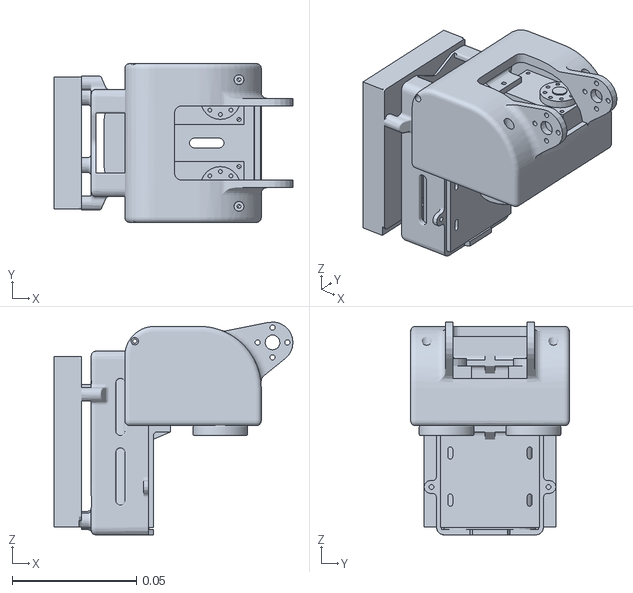
[picture p42: CAD file, 2026-11-03]
simulation/xgoduck_mjcf/assets/trunk_base.stl
0.0962 x 0.064 x 0.0857
