utkuoguzman/Microduck/3d_models/xgoduck_v2_numbered_stls/obj_13_组合体.stl

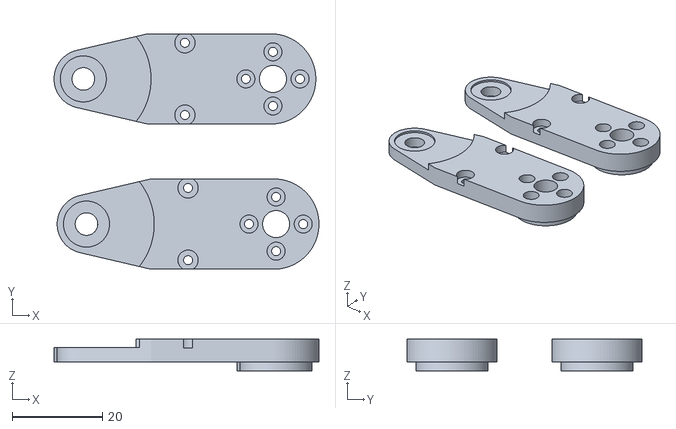
[picture p43: CAD file, 2026-11-03]
3d_models/xgoduck_v2_numbered_stls/obj_13_组合体.stl
58.7 x 52.1 x 7.00
