utkuoguzman/Microduck/3d_models/xgoduck_v2_structure_stls/2x_hip_rol_shell.stl

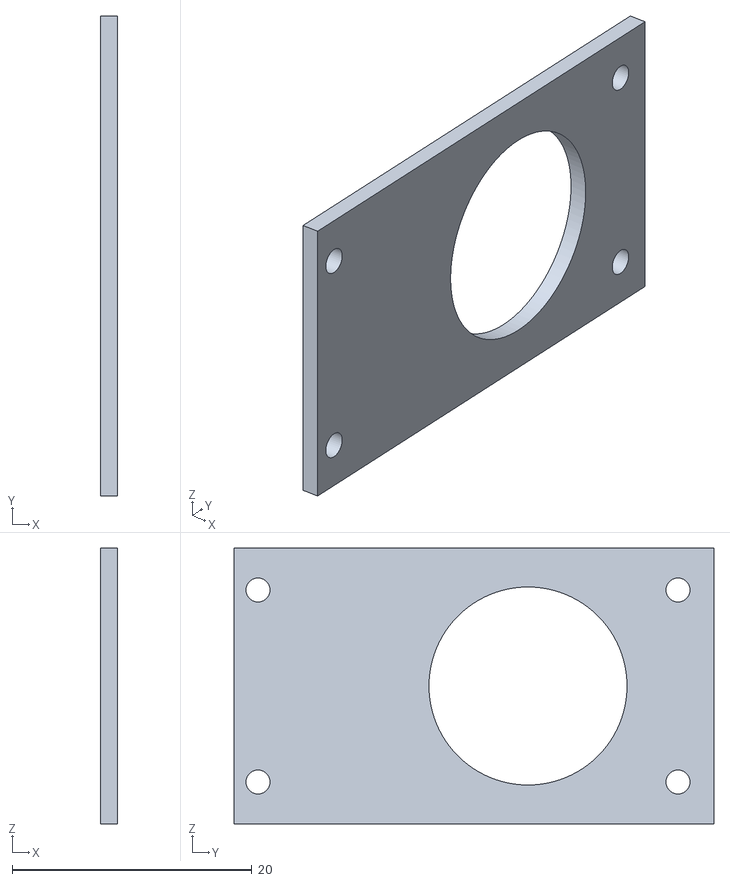
[picture p44: CAD file, 2026-11-03]
3d_models/xgoduck_v2_structure_stls/2x_hip_rol_shell.stl
1.40 x 40.0 x 23.0
