utkuoguzman/Microduck/simulation/microduck_mjcf/mjcf/assets/dc15_a01_horn_idle2_dummy.stl

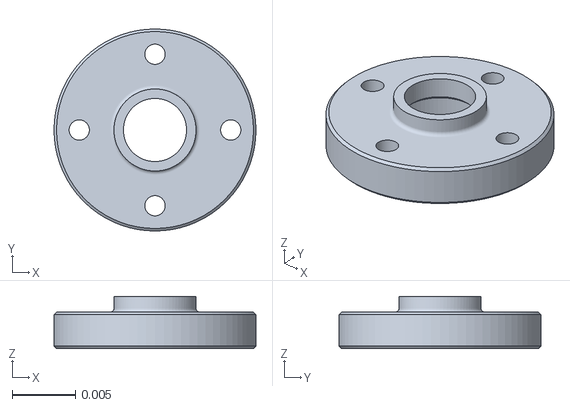
[picture p45: CAD file, 2026-11-03]
simulation/microduck_mjcf/mjcf/assets/dc15_a01_horn_idle2_dummy.stl
0.016 x 0.016 x 0.00415
