utkuoguzman/Microduck/3d_models/xgoduck_v2_numbered_stls/obj_6_眼睛.stl

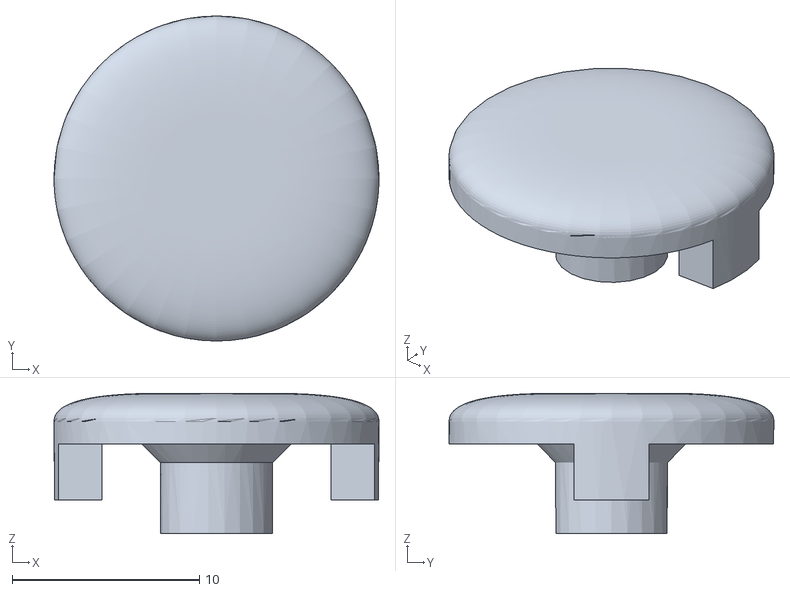
[picture p46: CAD file, 2026-11-03]
3d_models/xgoduck_v2_numbered_stls/obj_6_眼睛.stl
17.4 x 17.4 x 7.50
