utkuoguzman/Microduck/3d_models/xgoduck_v2_structure_stls/head_yaw.STL

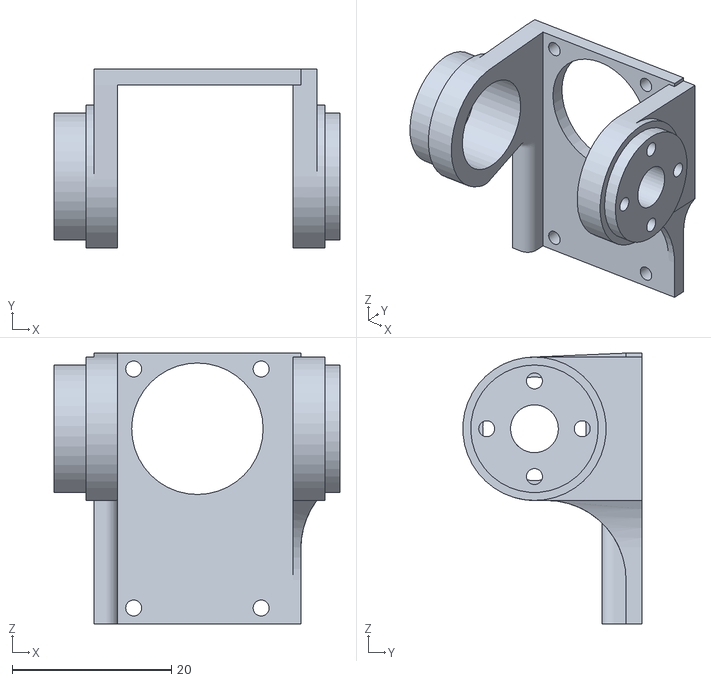
[picture p47: CAD file, 2026-11-03]
3d_models/xgoduck_v2_structure_stls/head_yaw.STL
35.9 x 22.5 x 34.0
