utkuoguzman/Microduck/simulation/microduck_mjcf/mjcf/assets/foot__configuration_right.stl

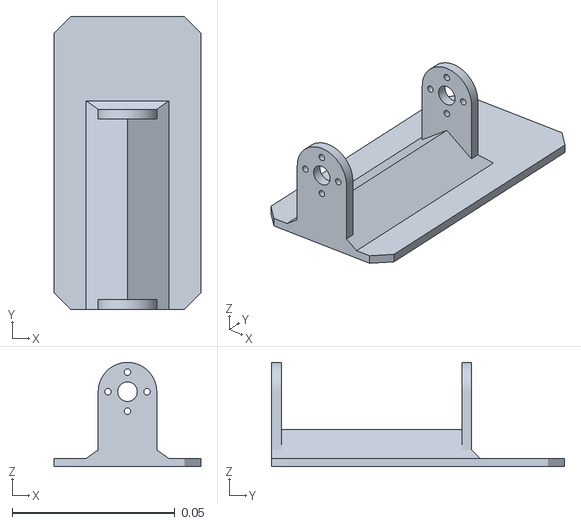
[picture p48: CAD file, 2026-11-03]
simulation/microduck_mjcf/mjcf/assets/foot__configuration_right.stl
0.045 x 0.09 x 0.032
