utkuoguzman/Microduck/3d_models/xgoduck_v2_numbered_stls/obj_10_组合体.stl

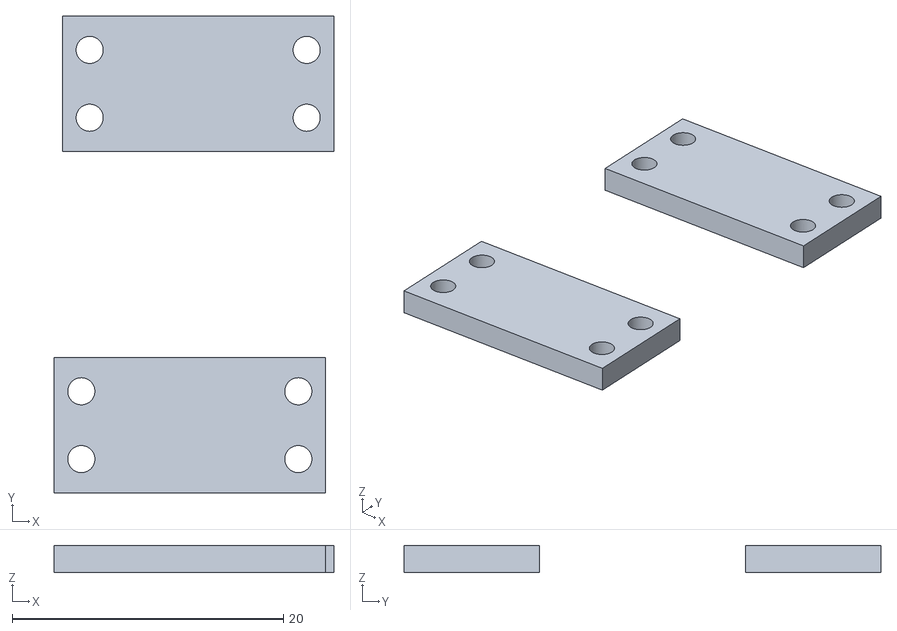
[picture p49: CAD file, 2026-11-03]
3d_models/xgoduck_v2_numbered_stls/obj_10_组合体.stl
20.6 x 35.2 x 2.00
