utkuoguzman/Microduck/3d_models/xgoduck_v2_structure_stls/eye_shell.stl

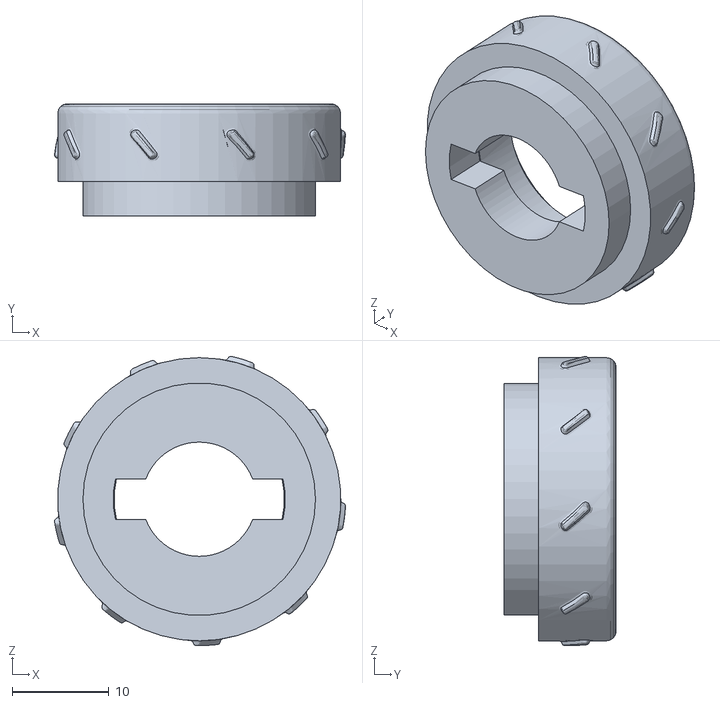
[picture p50: CAD file, 2026-11-03]
3d_models/xgoduck_v2_structure_stls/eye_shell.stl
30.0 x 11.6 x 29.8
