utkuoguzman/Microduck/simulation/microduck_mjcf/mjcf/assets/pelvis__configuration_right.stl

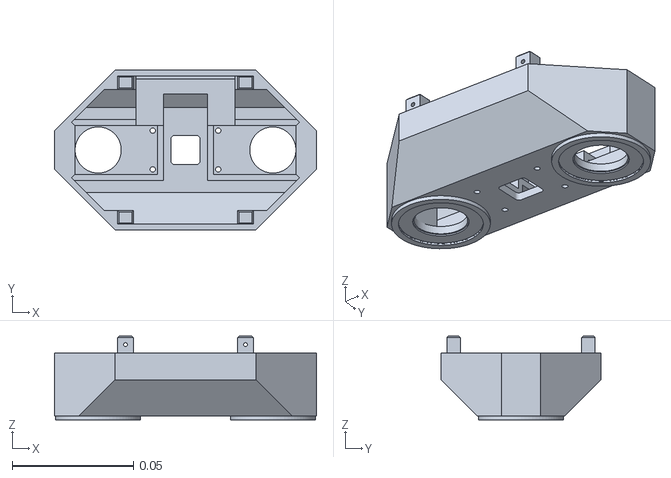
[picture p51: CAD file, 2026-11-03]
simulation/microduck_mjcf/mjcf/assets/pelvis__configuration_right.stl
0.108 x 0.066 x 0.0345
