utkuoguzman/Microduck/simulation/xgoduck_mjcf/assets/left_ankle.stl

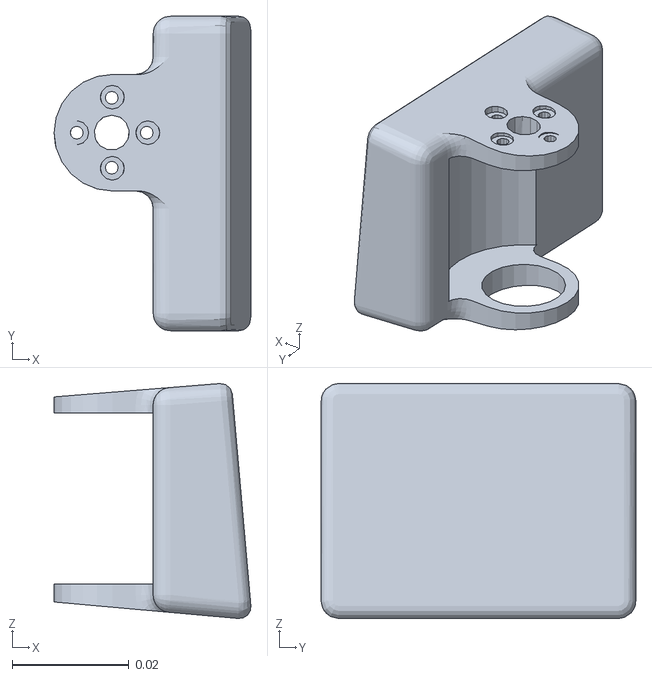
[picture p52: CAD file, 2026-11-03]
simulation/xgoduck_mjcf/assets/left_ankle.stl
0.0338 x 0.054 x 0.0403
