utkuoguzman/Microduck/3d_models/xgoduck_v2_structure_stls/2x_shank.stl

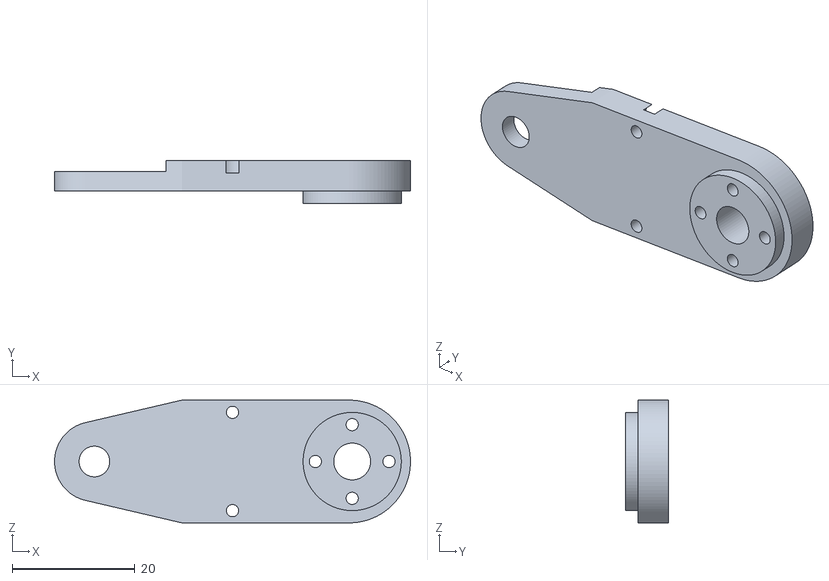
[picture p53: CAD file, 2026-11-03]
3d_models/xgoduck_v2_structure_stls/2x_shank.stl
58.0 x 7.00 x 20.0
