utkuoguzman/Microduck/simulation/microduck_mjcf/mjcf/assets/femur__configuration_right.stl

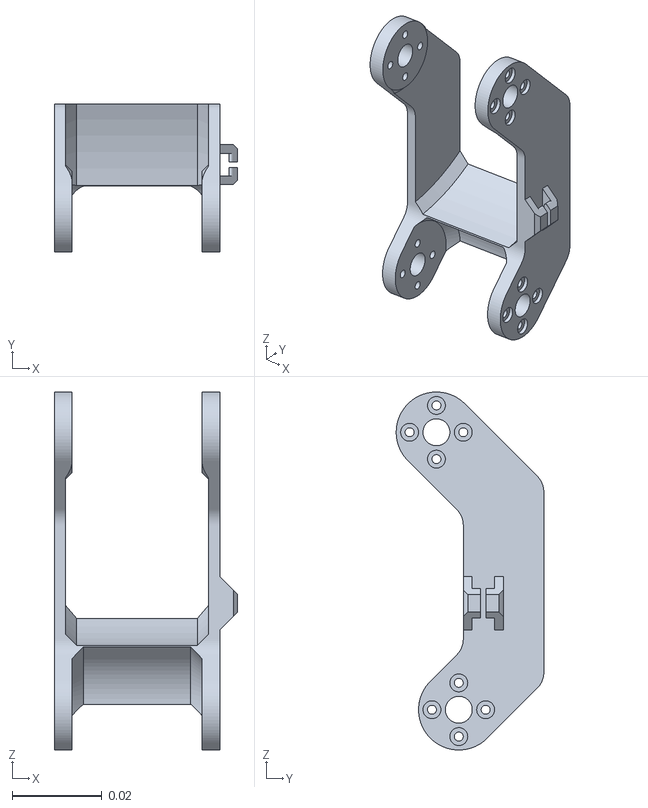
[picture p54: CAD file, 2026-11-03]
simulation/microduck_mjcf/mjcf/assets/femur__configuration_right.stl
0.041 x 0.033 x 0.08
