utkuoguzman/Microduck/simulation/xgoduck_mjcf/assets/right_knee.stl

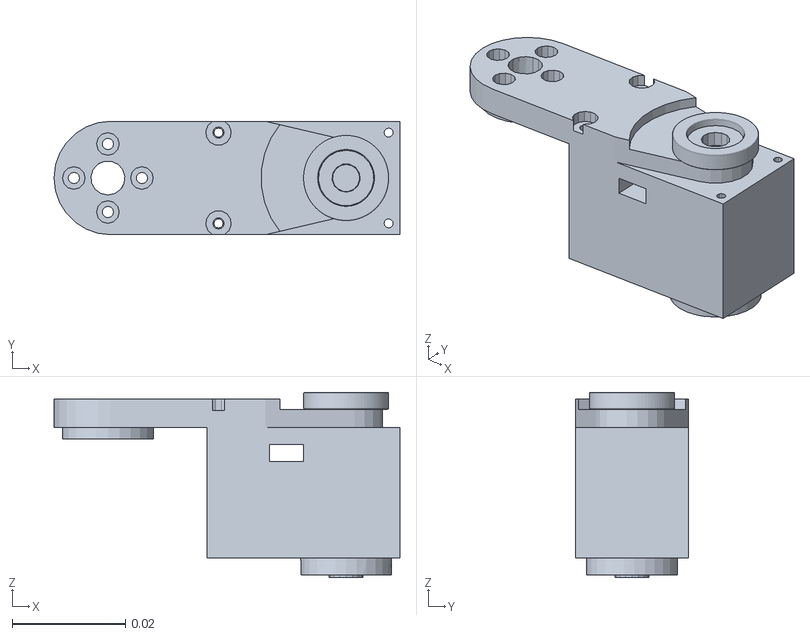
[picture p55: CAD file, 2026-11-03]
simulation/xgoduck_mjcf/assets/right_knee.stl
0.061 x 0.02 x 0.0327
