utkuoguzman/Microduck/3d_models/xgoduck_v2_structure_stls/2x_hip_rol_output.stl

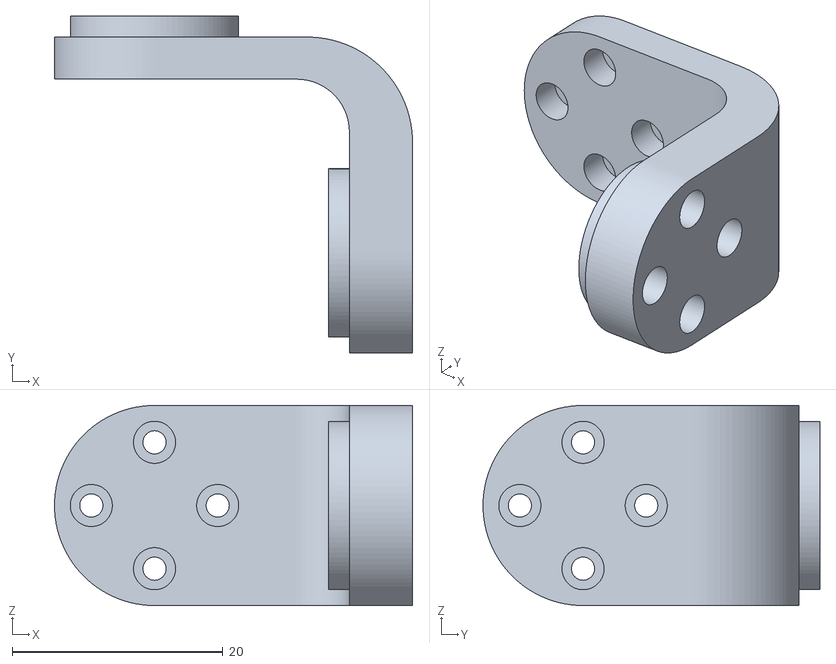
[picture p56: CAD file, 2026-11-03]
3d_models/xgoduck_v2_structure_stls/2x_hip_rol_output.stl
34.0 x 32.0 x 19.0
