utkuoguzman/Microduck/simulation/microduck_mjcf/mjcf/assets/hip_dbl_block__configuration_right.stl

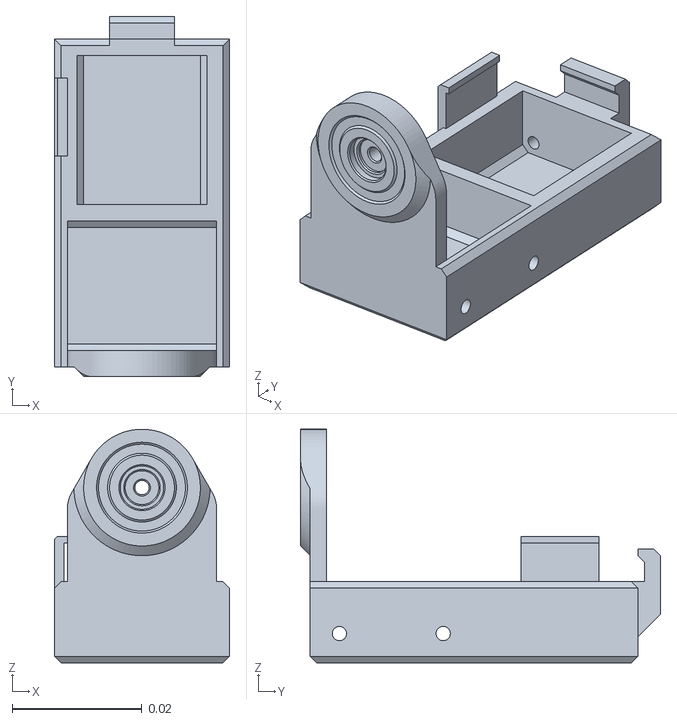
[picture p57: CAD file, 2026-11-03]
simulation/microduck_mjcf/mjcf/assets/hip_dbl_block__configuration_right.stl
0.027 x 0.0555 x 0.036
