utkuoguzman/Microduck/simulation/xgoduck_mjcf/assets/head_pitch.stl

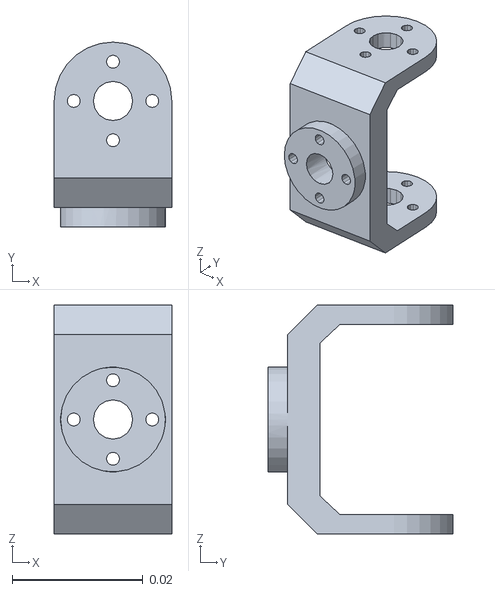
[picture p58: CAD file, 2026-11-03]
simulation/xgoduck_mjcf/assets/head_pitch.stl
0.018 x 0.0283 x 0.035
