utkuoguzman/Microduck/3d_models/xgoduck_v2_numbered_stls/obj_7_身体背板.stl

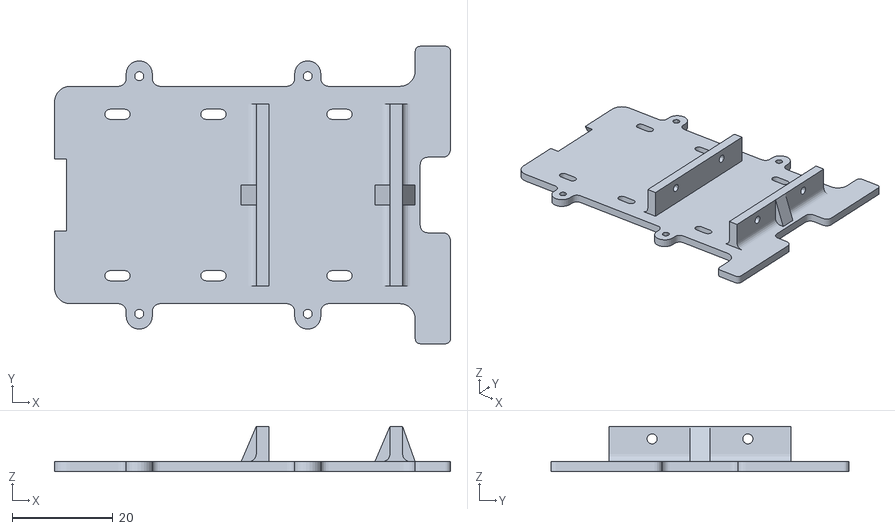
[picture p59: CAD file, 2026-11-03]
3d_models/xgoduck_v2_numbered_stls/obj_7_身体背板.stl
78.5 x 59.0 x 9.00
