utkuoguzman/Microduck/simulation/microduck_mjcf/mjcf/assets/bts2_m2_6x8.stl

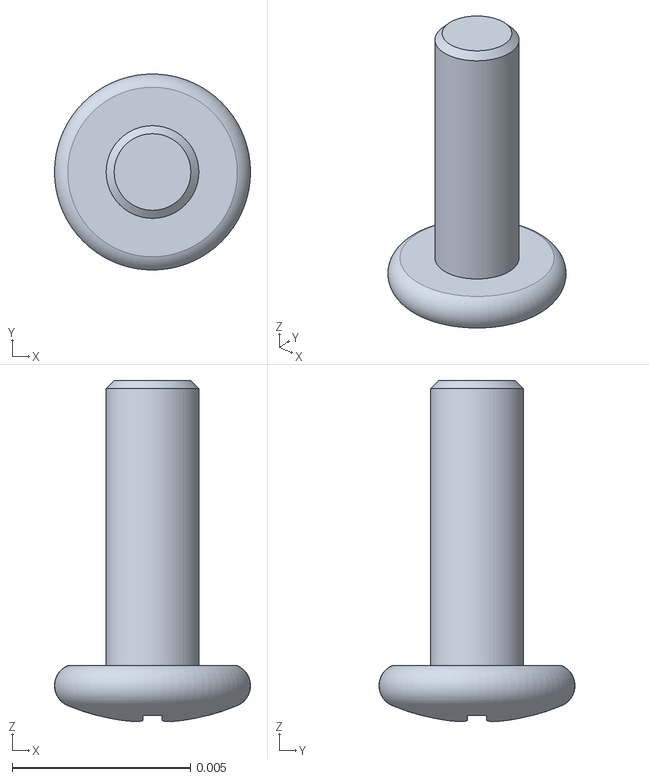
[picture p60: CAD file, 2026-11-03]
simulation/microduck_mjcf/mjcf/assets/bts2_m2_6x8.stl
0.0055 x 0.0055 x 0.00957
