utkuoguzman/Microduck/simulation/microduck_mjcf/mjcf/assets/arm_bearing_support__configuration_right.stl

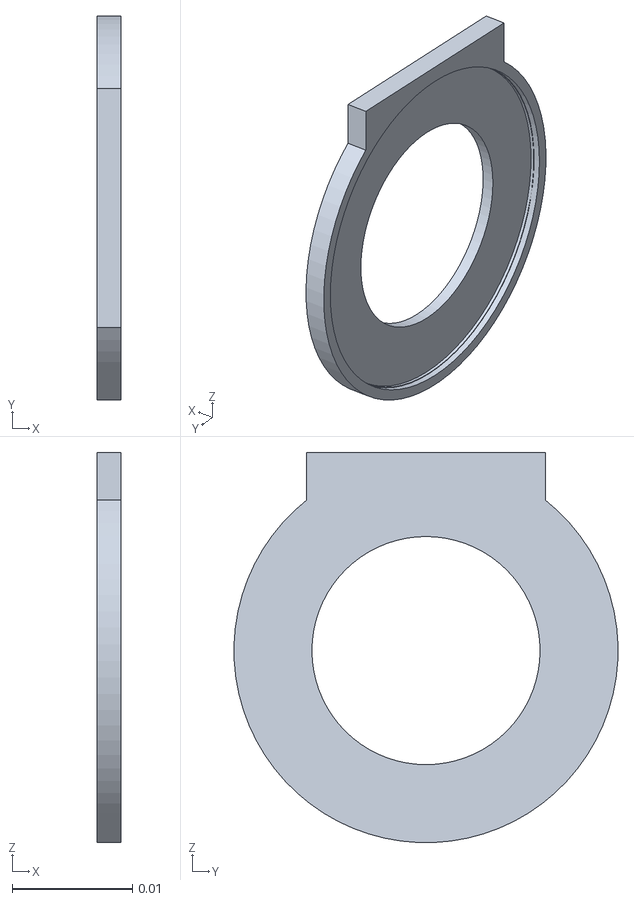
[picture p61: CAD file, 2026-11-03]
simulation/microduck_mjcf/mjcf/assets/arm_bearing_support__configuration_right.stl
0.002 x 0.032 x 0.0325
