utkuoguzman/Microduck/3d_models/xgoduck_v2_numbered_stls/obj_12_组合体.stl

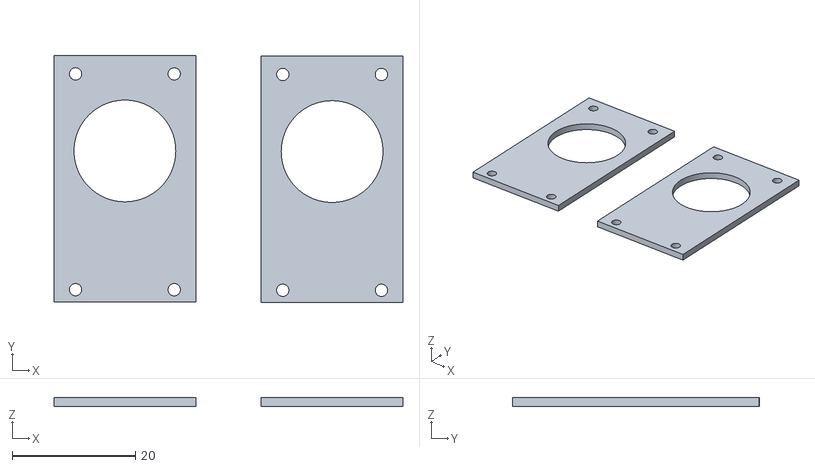
[picture p62: CAD file, 2026-11-03]
3d_models/xgoduck_v2_numbered_stls/obj_12_组合体.stl
56.6 x 40.1 x 1.40
