utkuoguzman/Microduck/3d_models/xgoduck_v2_structure_stls/body.stl

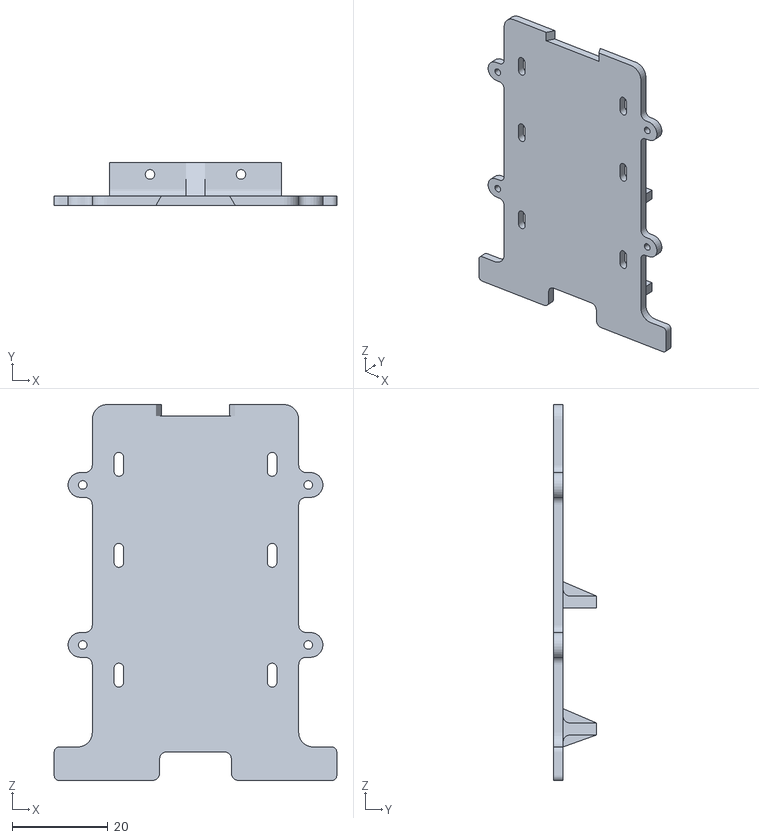
[picture p63: CAD file, 2026-11-03]
3d_models/xgoduck_v2_structure_stls/body.stl
59.0 x 9.00 x 78.5
