utkuoguzman/Microduck/simulation/xgoduck_mjcf/assets/neck_pitch.stl

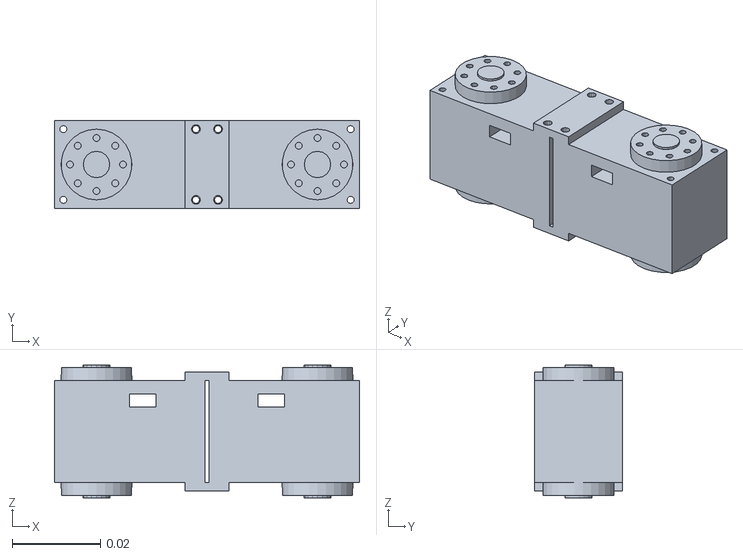
[picture p64: CAD file, 2026-11-03]
simulation/xgoduck_mjcf/assets/neck_pitch.stl
0.069 x 0.02 x 0.03
