utkuoguzman/Microduck/3d_models/xgoduck_v2_numbered_stls/obj_25_000.stl

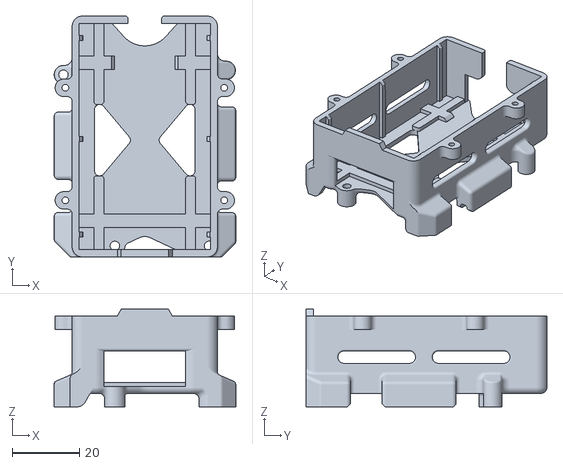
[picture p65: CAD file, 2026-11-03]
3d_models/xgoduck_v2_numbered_stls/obj_25_000.stl
53.9 x 71.5 x 29.0
