utkuoguzman/Microduck/3d_models/xgoduck_v2_structure_stls/2x_tire_support.STL

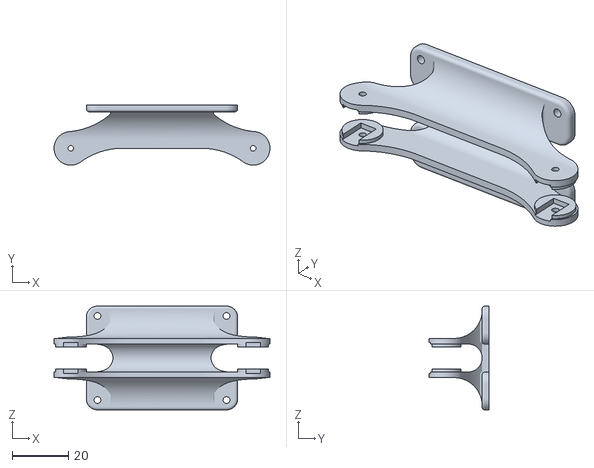
[picture p66: CAD file, 2026-11-03]
3d_models/xgoduck_v2_structure_stls/2x_tire_support.STL
77.0 x 21.5 x 37.0
