utkuoguzman/Microduck/simulation/microduck_mjcf/mjcf/assets/chest__configuration_right.stl

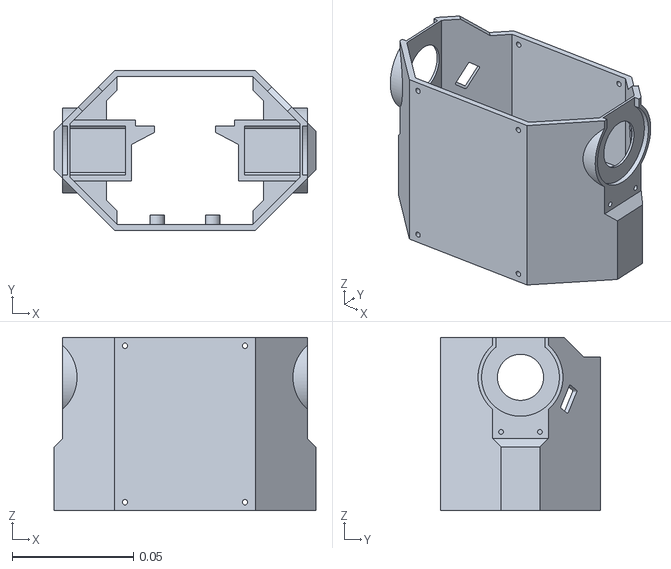
[picture p67: CAD file, 2026-11-03]
simulation/microduck_mjcf/mjcf/assets/chest__configuration_right.stl
0.108 x 0.066 x 0.0715
