utkuoguzman/Microduck/simulation/microduck_mjcf/mjcf/assets/xl330.stl

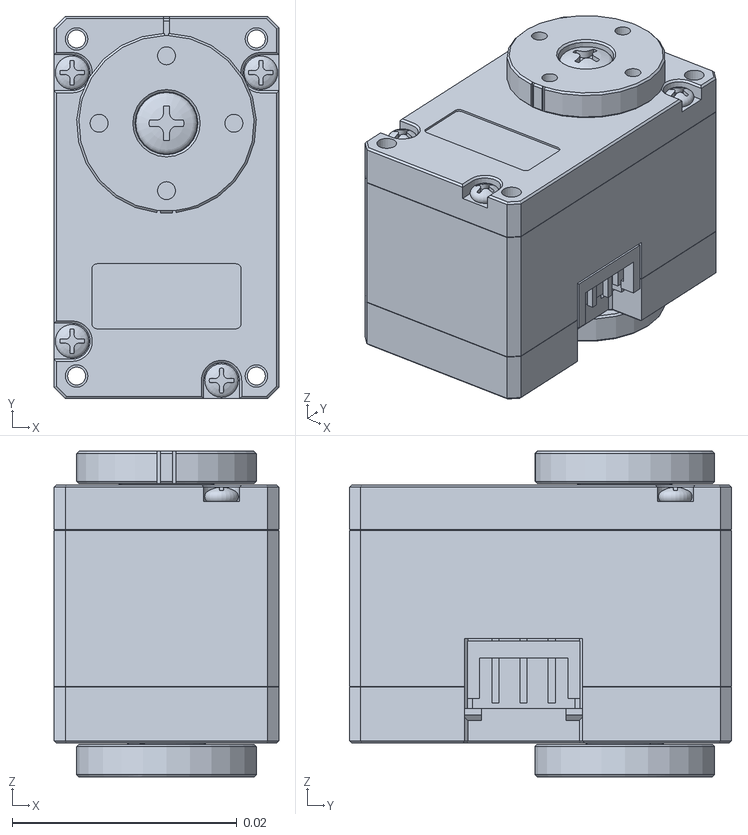
[picture p68: CAD file, 2026-11-03]
simulation/microduck_mjcf/mjcf/assets/xl330.stl
0.02 x 0.034 x 0.029
