utkuoguzman/Microduck/3d_models/xgoduck_v2_numbered_stls/obj_3_头盖.stl

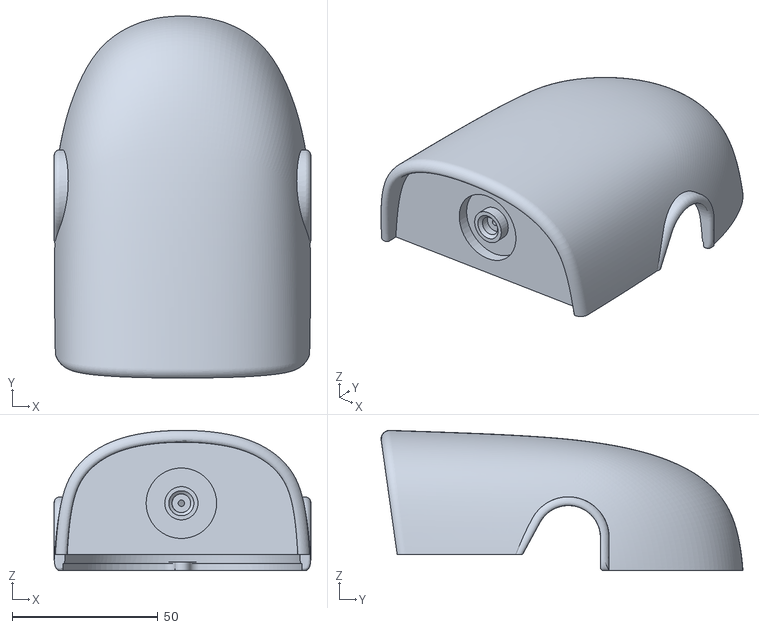
[picture p69: CAD file, 2026-11-03]
3d_models/xgoduck_v2_numbered_stls/obj_3_头盖.stl
88.0 x 124.1 x 48.1
