utkuoguzman/Microduck/3d_models/xgoduck_v2_numbered_stls/obj_14_组合体.stl

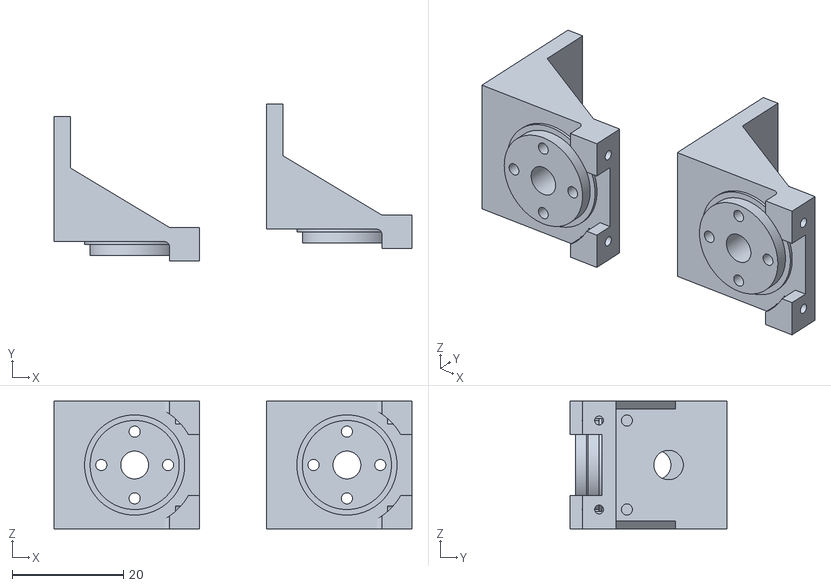
[picture p70: CAD file, 2026-11-03]
3d_models/xgoduck_v2_numbered_stls/obj_14_组合体.stl
64.4 x 28.2 x 23.0
