utkuoguzman/Microduck/3d_models/xgoduck_v2_structure_stls/hip_yaw_support.STL

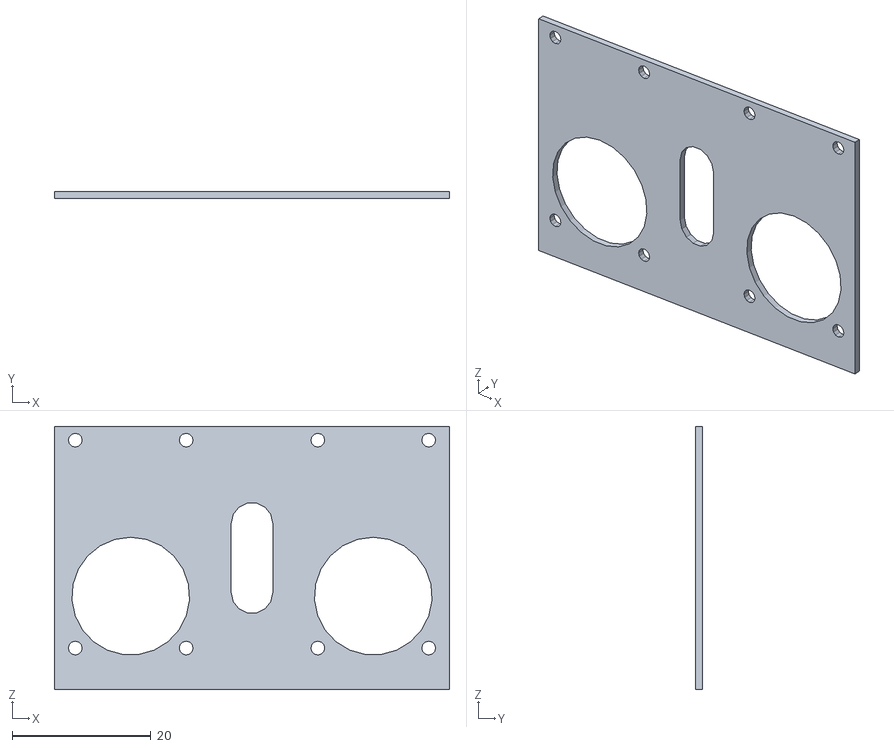
[picture p71: CAD file, 2026-11-03]
3d_models/xgoduck_v2_structure_stls/hip_yaw_support.STL
57.0 x 1.00 x 38.0
