utkuoguzman/Microduck/simulation/microduck_mjcf/mjcf/assets/battery.stl

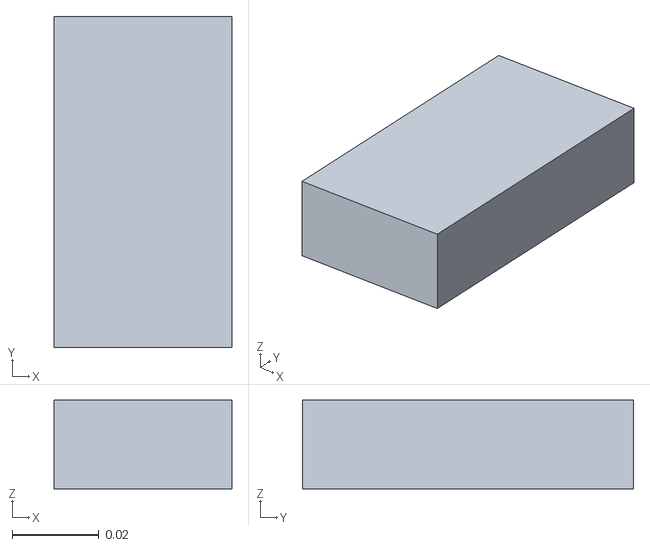
[picture p72: CAD file, 2026-11-03]
simulation/microduck_mjcf/mjcf/assets/battery.stl
0.041 x 0.0763 x 0.0205
