utkuoguzman/Microduck/3d_models/xgoduck_v2_numbered_stls/obj_11_组合体.stl

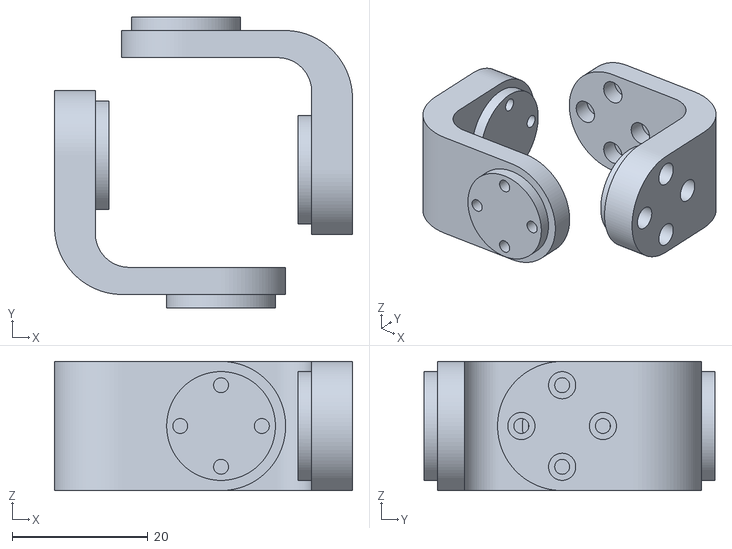
[picture p73: CAD file, 2026-11-03]
3d_models/xgoduck_v2_numbered_stls/obj_11_组合体.stl
43.8 x 42.8 x 19.0
