utkuoguzman/Microduck/3d_models/xgoduck_v2_structure_stls/body_left_shell.stl

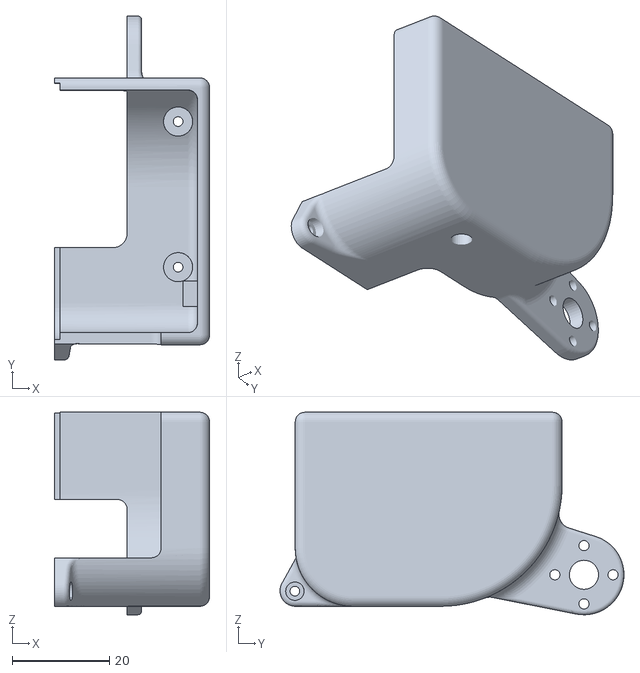
[picture p74: CAD file, 2026-11-03]
3d_models/xgoduck_v2_structure_stls/body_left_shell.stl
32.0 x 70.9 x 41.7
