utkuoguzman/Microduck/simulation/microduck_mjcf/mjcf/assets/dc15_a01_idle_cap_dummy.stl

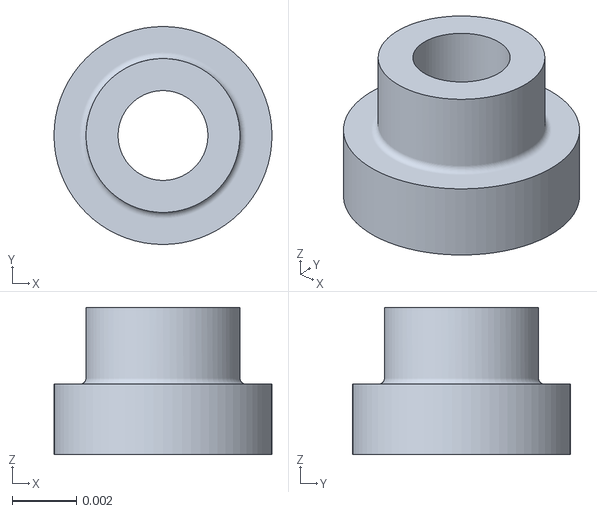
[picture p75: CAD file, 2026-11-03]
simulation/microduck_mjcf/mjcf/assets/dc15_a01_idle_cap_dummy.stl
0.0068 x 0.0068 x 0.0046
