utkuoguzman/Microduck/3d_models/xgoduck_v2_structure_stls/2x_foot_bottom_tpu.stl

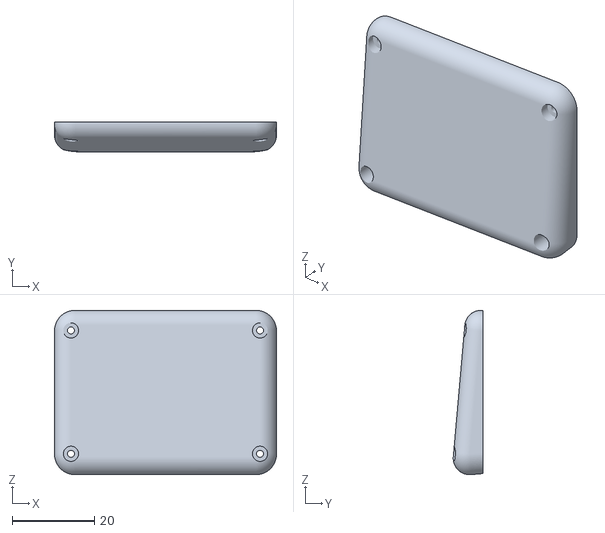
[picture p76: CAD file, 2026-11-03]
3d_models/xgoduck_v2_structure_stls/2x_foot_bottom_tpu.stl
54.0 x 7.20 x 40.0
