utkuoguzman/Microduck/simulation/microduck_mjcf/mjcf/assets/spacer__configuration_right.stl

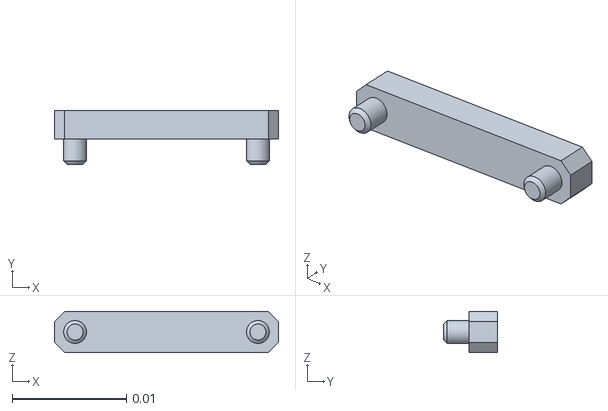
[picture p77: CAD file, 2026-11-03]
simulation/microduck_mjcf/mjcf/assets/spacer__configuration_right.stl
0.0196 x 0.0047 x 0.0036
