utkuoguzman/Microduck/3d_models/xgoduck_v2_numbered_stls/obj_8_组合体.stl

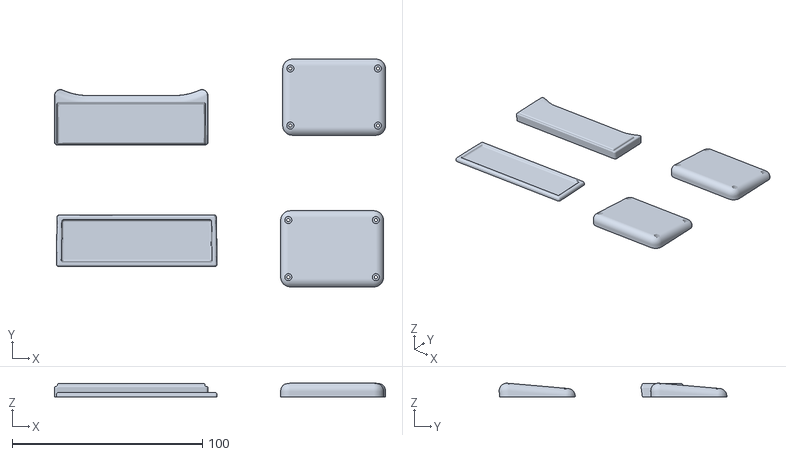
[picture p78: CAD file, 2026-11-03]
3d_models/xgoduck_v2_numbered_stls/obj_8_组合体.stl
173.9 x 119.6 x 7.20
