utkuoguzman/Microduck/3d_models/xgoduck_v2_structure_stls/2x_hip_yaw2rol.STL

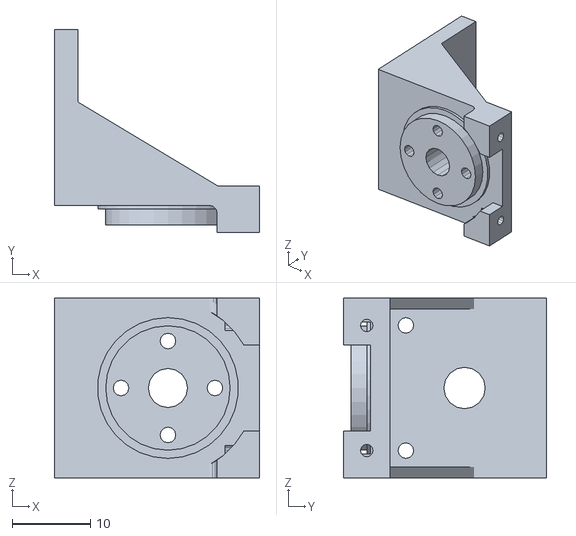
[picture p79: CAD file, 2026-11-03]
3d_models/xgoduck_v2_structure_stls/2x_hip_yaw2rol.STL
26.2 x 26.0 x 23.0
