utkuoguzman/Microduck/simulation/microduck_mjcf/mjcf/assets/head__configuration_right.stl

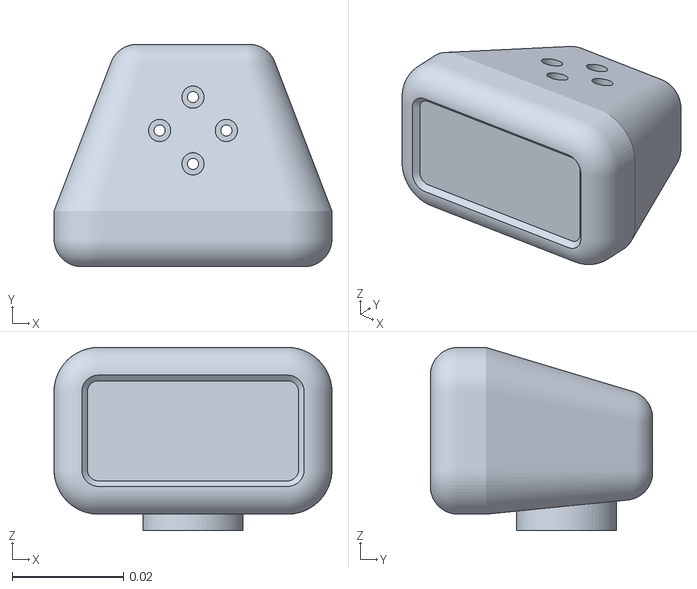
[picture p80: CAD file, 2026-11-03]
simulation/microduck_mjcf/mjcf/assets/head__configuration_right.stl
0.05 x 0.04 x 0.0329
