utkuoguzman/Microduck/3d_models/xgoduck_v2_structure_stls/4x_tire_axis.STL

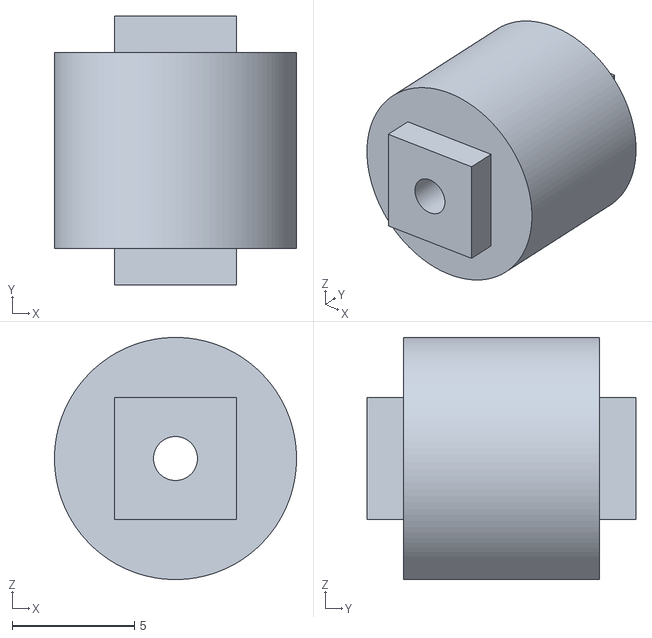
[picture p81: CAD file, 2026-11-03]
3d_models/xgoduck_v2_structure_stls/4x_tire_axis.STL
9.90 x 11.0 x 9.90
