utkuoguzman/Microduck/simulation/microduck_mjcf/mjcf/assets/shoulder.stl

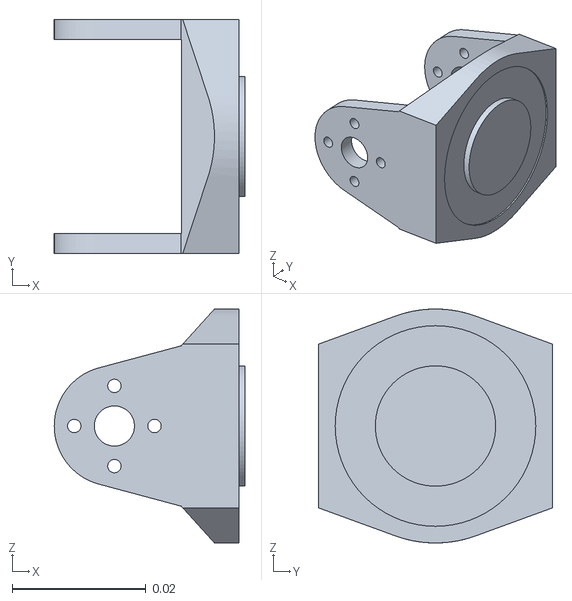
[picture p82: CAD file, 2026-11-03]
simulation/microduck_mjcf/mjcf/assets/shoulder.stl
0.0285 x 0.035 x 0.035
