utkuoguzman/Microduck/3d_models/xgoduck_v2_numbered_stls/obj_24_组合体.stl

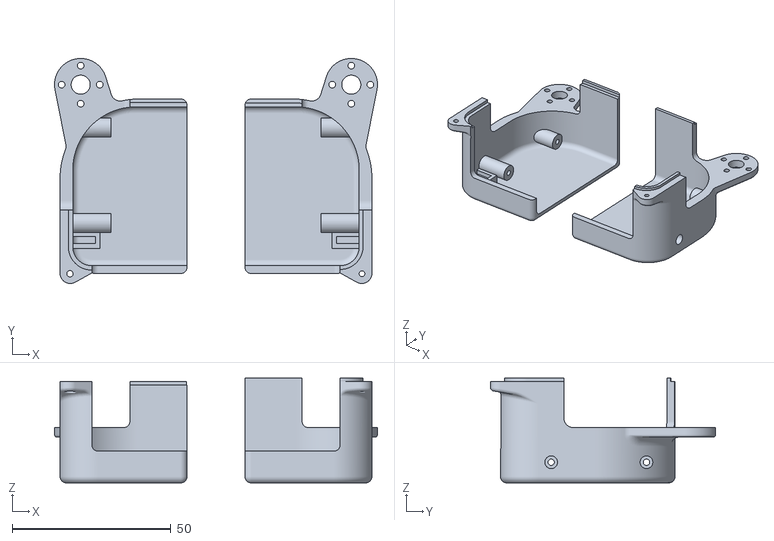
[picture p83: CAD file, 2026-11-03]
3d_models/xgoduck_v2_numbered_stls/obj_24_组合体.stl
101.7 x 70.9 x 33.0
