utkuoguzman/Microduck/simulation/microduck_mjcf/mjcf/assets/hip__configuration_right.stl

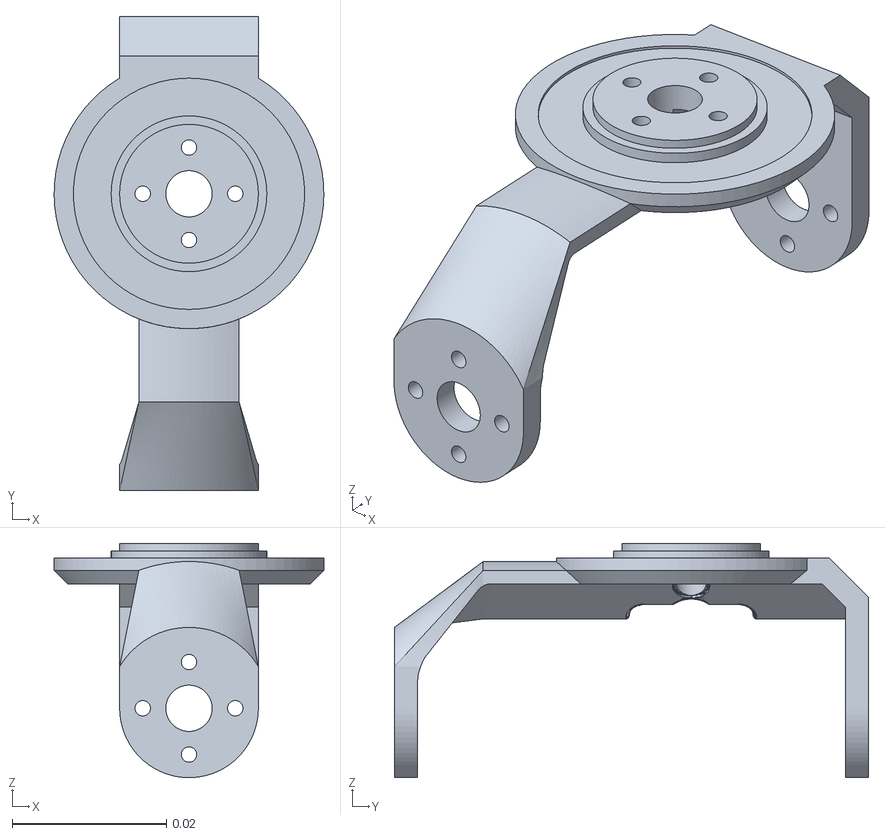
[picture p84: CAD file, 2026-11-03]
simulation/microduck_mjcf/mjcf/assets/hip__configuration_right.stl
0.035 x 0.0615 x 0.0304
