utkuoguzman/Microduck/3d_models/xgoduck_v2_structure_stls/mouth_up_tpu.stl

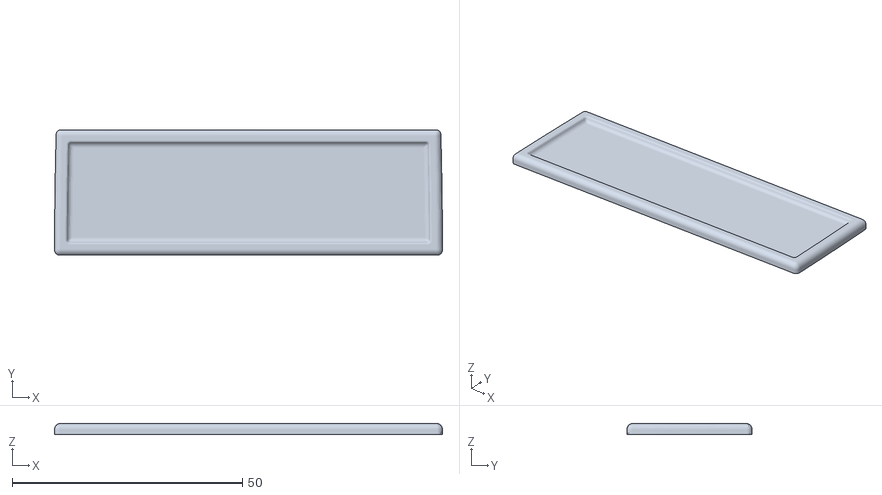
[picture p85: CAD file, 2026-11-03]
3d_models/xgoduck_v2_structure_stls/mouth_up_tpu.stl
84.3 x 27.2 x 2.40
