utkuoguzman/Microduck/3d_models/xgoduck_v2_structure_stls/2x_neck.stl

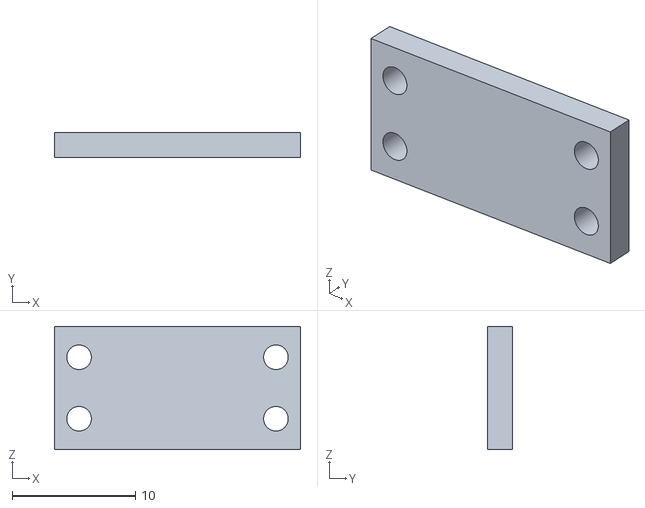
[picture p86: CAD file, 2026-11-03]
3d_models/xgoduck_v2_structure_stls/2x_neck.stl
20.0 x 2.00 x 10.0
