utkuoguzman/Microduck/3d_models/xgoduck_v2_structure_stls/head_servo_support.stl

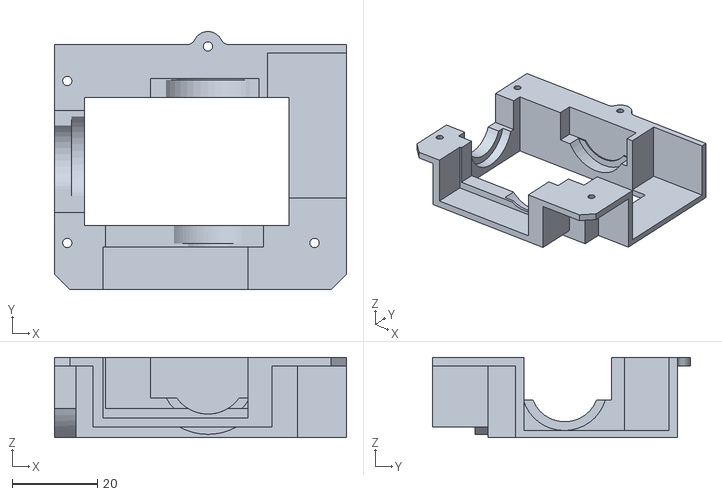
[picture p87: CAD file, 2026-11-03]
3d_models/xgoduck_v2_structure_stls/head_servo_support.stl
68.5 x 60.5 x 18.8
