utkuoguzman/Microduck/(list of files, cad)

Other CAD files:
src/c_dm_vlio/microduck_dm_vlio.obj
simulation/xgoduck_mjcf/assets/left_hip_yaw.stl
3d_models/xgoduck_v2_numbered_stls/obj_2_大腿左外壳.stl
3d_models/xgoduck_v2_structure_stls/right_foot.stl
simulation/xgoduck_mjcf/assets/left_hip_roll.stl
simulation/xgoduck_mjcf/assets/left_hip_pitch.stl
3d_models/xgoduck_v2_numbered_stls/obj_20_眼睛外壳.stl
3d_models/xgoduck_v2_numbered_stls/obj_19_2x_ankle_axis.STL.stl
3d_models/xgoduck_v2_structure_stls/eye.stl
simulation/xgoduck_mjcf/assets/right_ankle.stl
3d_models/xgoduck_v2_numbered_stls/obj_21_2x_ankle_axis.STL.stl
3d_models/xgoduck_v2_structure_stls/head_pitch.stl
simulation/xgoduck_mjcf/assets/left_knee.stl
simulation/microduck_mjcf/mjcf/assets/femur__configuration_left.stl
3d_models/xgoduck_v2_numbered_stls/obj_22_head_yaw.STEP.stl
3d_models/xgoduck_v2_structure_stls/battery.stl
3d_models/xgoduck_v2_structure_stls/thigh_right_shell.stl
simulation/microduck_mjcf/mjcf/assets/tibia__configuration_right.stl
3d_models/xgoduck_v2_numbered_stls/obj_17_右脚.stl
3d_models/xgoduck_v2_numbered_stls/obj_23_hip_yaw_support.STL.stl
simulation/microduck_mjcf/mjcf/assets/hip_dbl_block__configuration_left.stl
3d_models/xgoduck_v2_numbered_stls/obj_15_下巴.stl
3d_models/xgoduck_v2_structure_stls/thigh_left_shell.stl
3d_models/xgoduck_v2_structure_stls/head.stl
3d_models/xgoduck_v2_structure_stls/head_shell.stl
3d_models/xgoduck_v2_structure_stls/left_foot.stl
simulation/microduck_mjcf/mjcf/assets/ankle_dbl_block__configuration_right.scad
simulation/microduck_mjcf/mjcf/assets/femur__configuration_left.scad
simulation/microduck_mjcf/mjcf/assets/femur__configuration_right.scad
simulation/microduck_mjcf/mjcf/assets/foot__configuration_right.scad
diagrams/reference_pcba/DWG/ArduinoUnoQV1.1.DWG
diagrams/reference_pcba/archive/pre-V1.1/ArduinoUnoQ.DWG
diagrams/reference_pcba/archive/pre-V1.1/ArduinoUnoQ.step
simulation/microduck_mjcf/mjcf/assets/hip_dbl_block__configuration_left.scad
simulation/microduck_mjcf/mjcf/assets/hip_dbl_block__configuration_right.scad
simulation/microduck_mjcf/mjcf/assets/pelvis__configuration_right.scad
simulation/microduck_mjcf/mjcf/assets/radius.scad
simulation/microduck_mjcf/mjcf/assets/tibia__configuration_left.scad
simulation/microduck_mjcf/mjcf/assets/tibia__configuration_right.scad
