utkuoguzman/Microduck/docs/media/print-orientation-reference.png

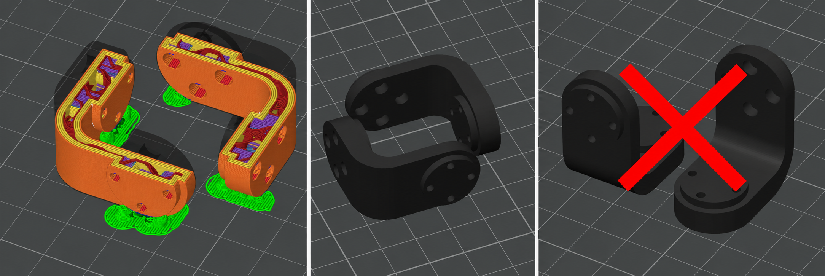
docs/media/print-orientation-reference.png
