utkuoguzman/Microduck/(list of files, drawings)

Other design files:
diagrams/Microduck_PiZeroW_ESP32_EasyEDA.json
diagrams/reference_pcba/archive/pre-V1.1/ArduinoUnoQ.PcbDoc
diagrams/reference_pcba/archive/pre-V1.1/ArduinoUnoQ.SchDoc
diagrams/reference_pcba/ArduinoUnoQV1.1.SchDoc
